DerKodex-Repo-Curator/pursuit-drone/docs/media/arch_01_vision.png

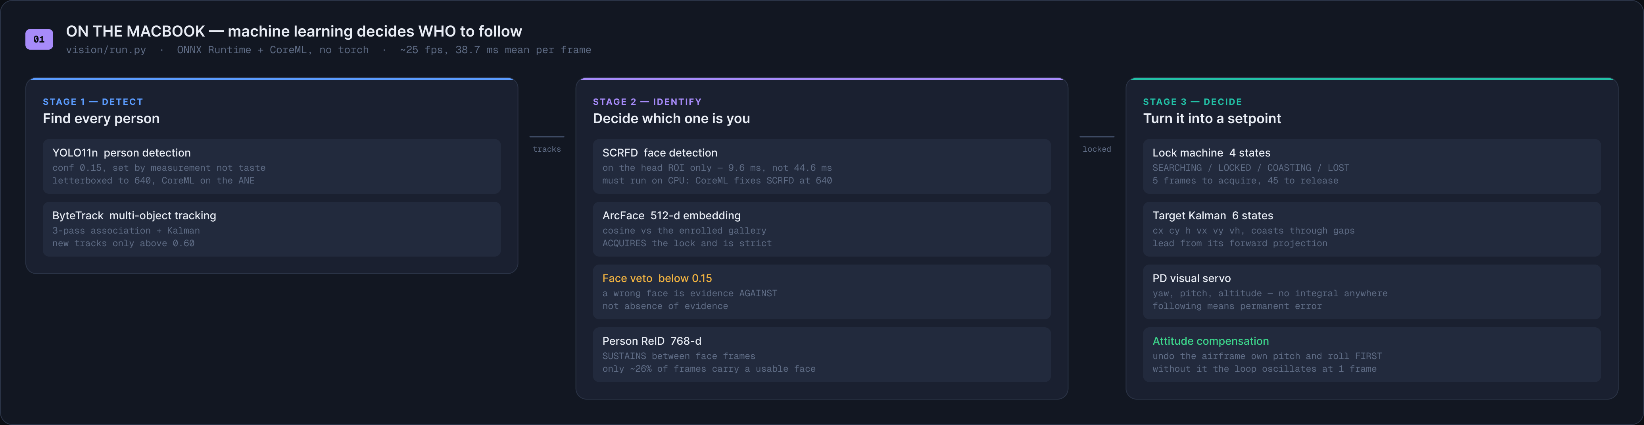
docs/media/arch_01_vision.png
