DerKodex-Repo-Curator/pursuit-drone/docs/media/arch_02_link.png

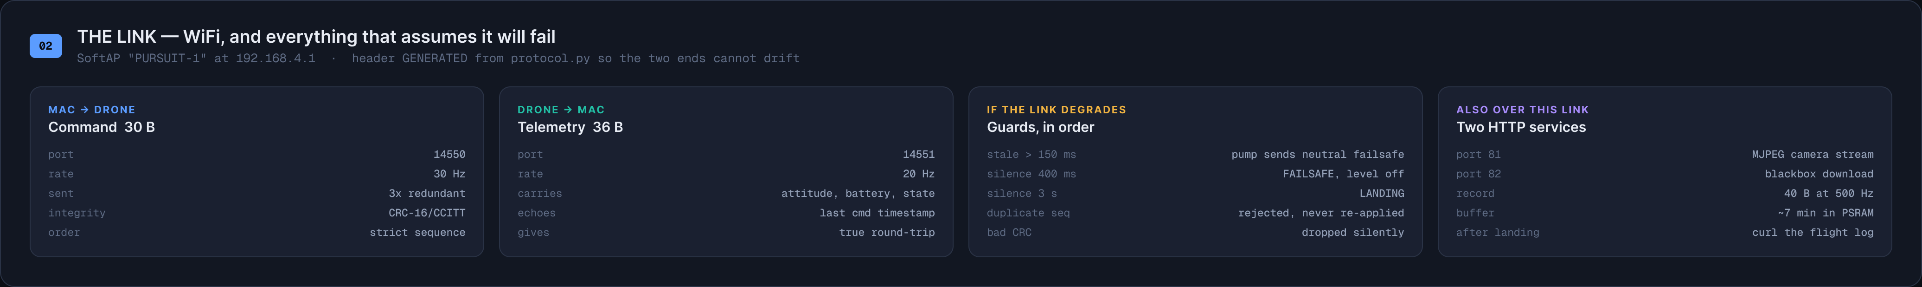
docs/media/arch_02_link.png
