DerKodex-Repo-Curator/pursuit-drone/docs/media/arch_03_firmware.png

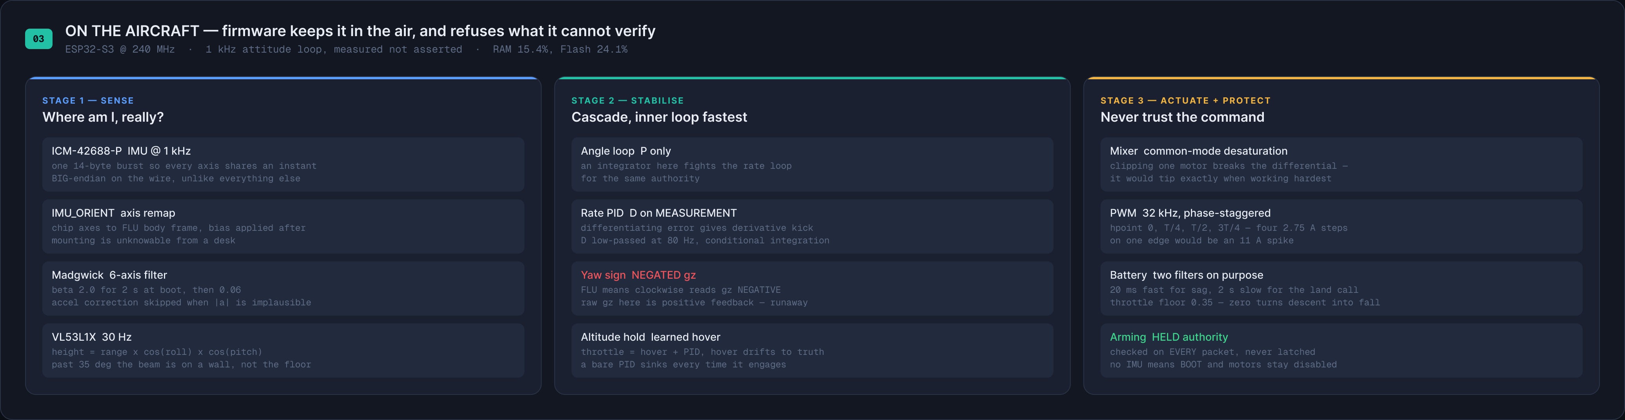
docs/media/arch_03_firmware.png
