DerKodex-Repo-Curator/pursuit-drone/docs/media/figjam_01_vision_pipeline.png

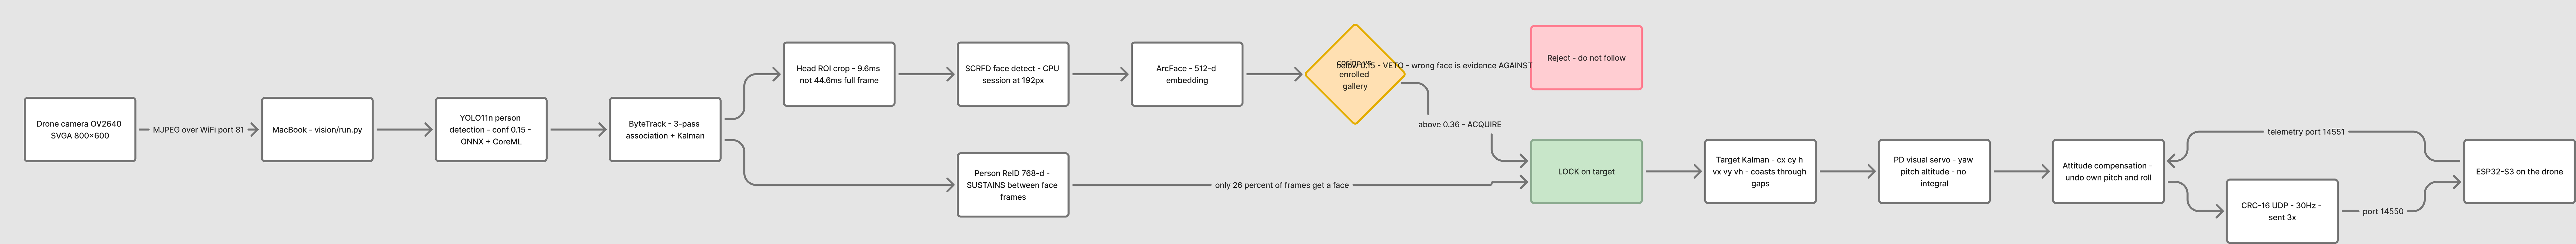
docs/media/figjam_01_vision_pipeline.png
