DerKodex-Repo-Curator/pursuit-drone/docs/media/figjam_02_firmware_loop.png

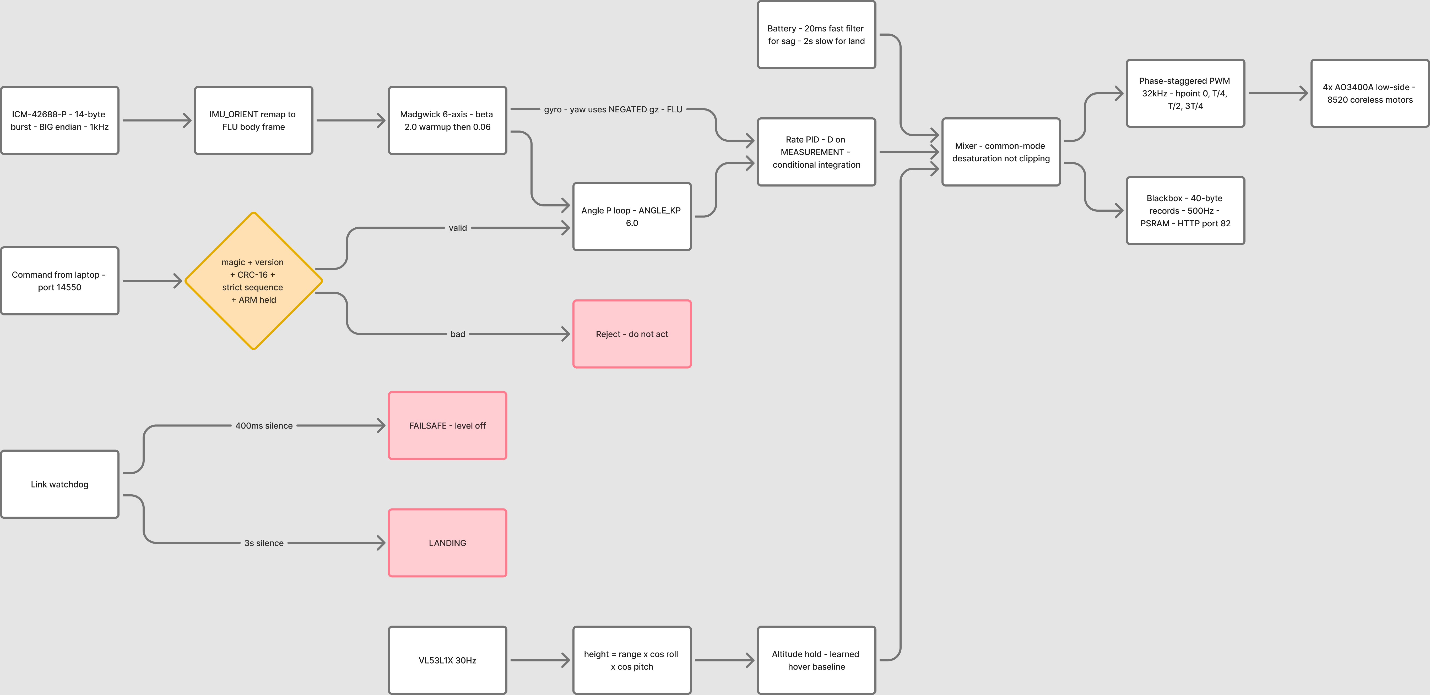
docs/media/figjam_02_firmware_loop.png
