DerKodex-Repo-Curator/pursuit-drone/docs/media/figjam_03_connect.png

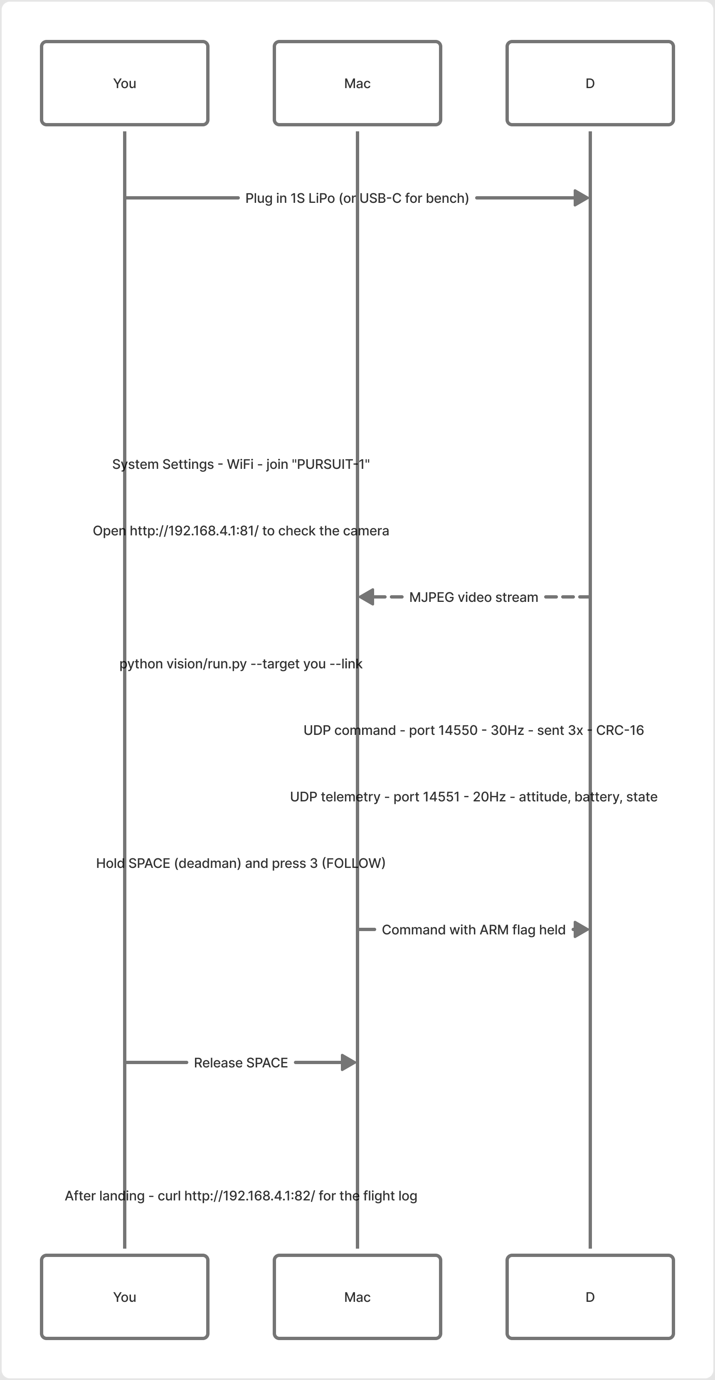
docs/media/figjam_03_connect.png
