DerKodex-Repo-Curator/pursuit-drone/docs/media/figjam_04_control_modes.png

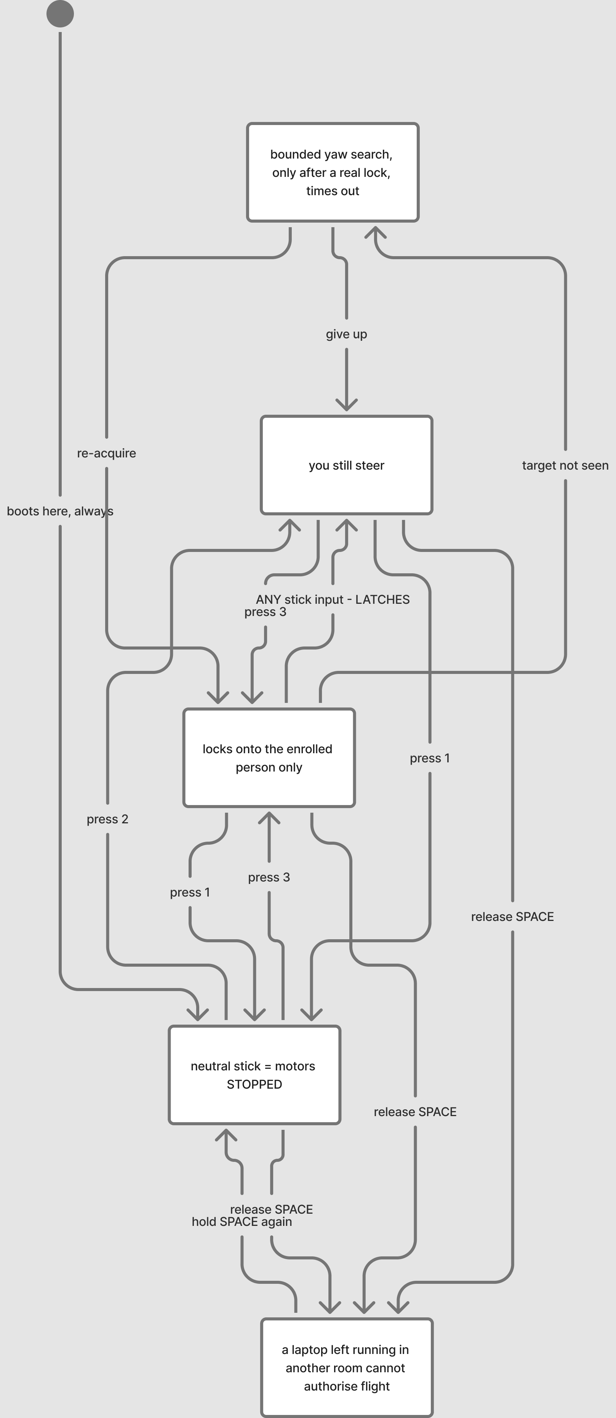
docs/media/figjam_04_control_modes.png
