DerKodex-Repo-Curator/pursuit-drone/docs/media/pursuit_architecture.png

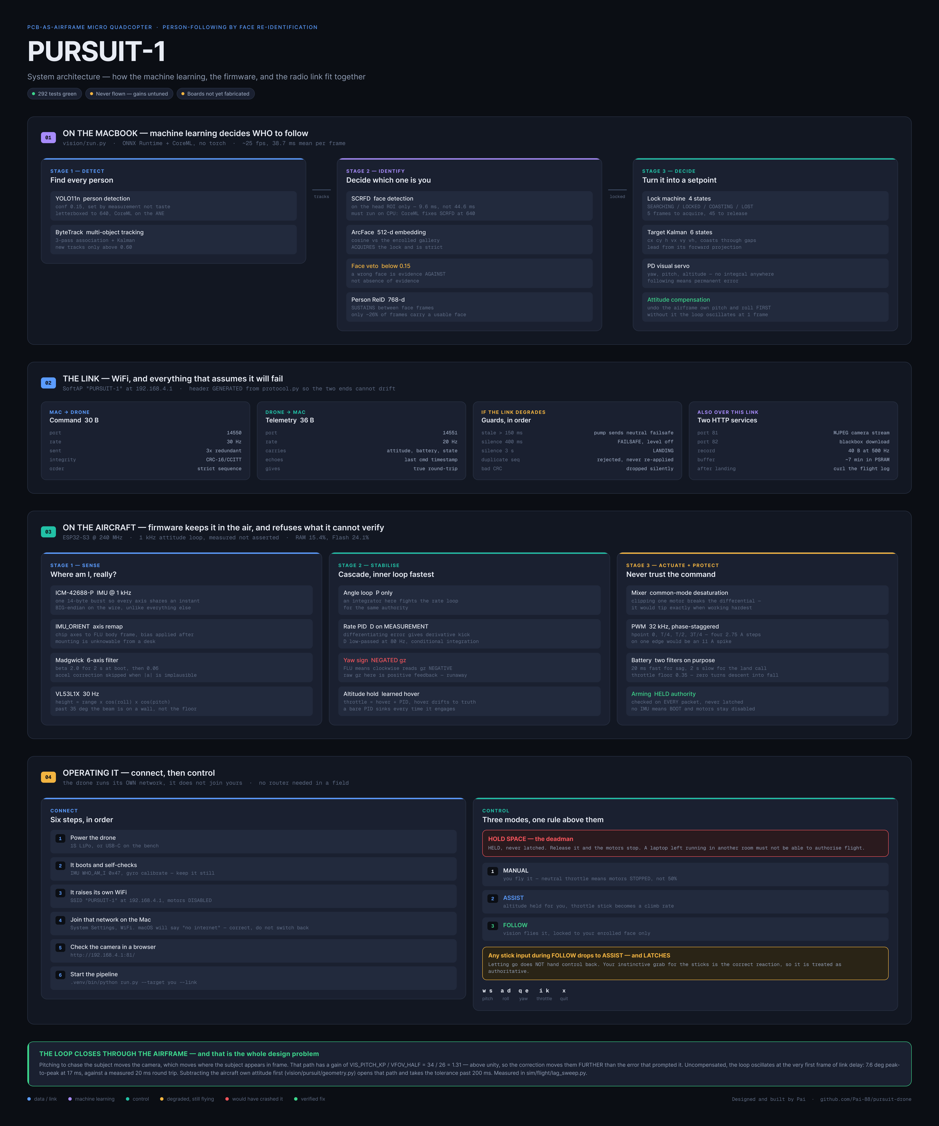
docs/media/pursuit_architecture.png
