DerKodex-Repo-Curator/pursuit-drone/docs/media/pursuit_mindmap.png

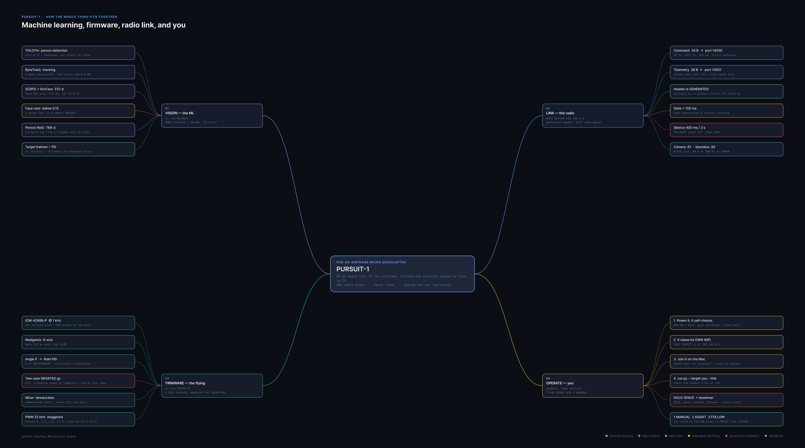
docs/media/pursuit_mindmap.png
