DerKodex-Repo-Curator/pursuit-drone/docs/media/pursuit_process_map.png

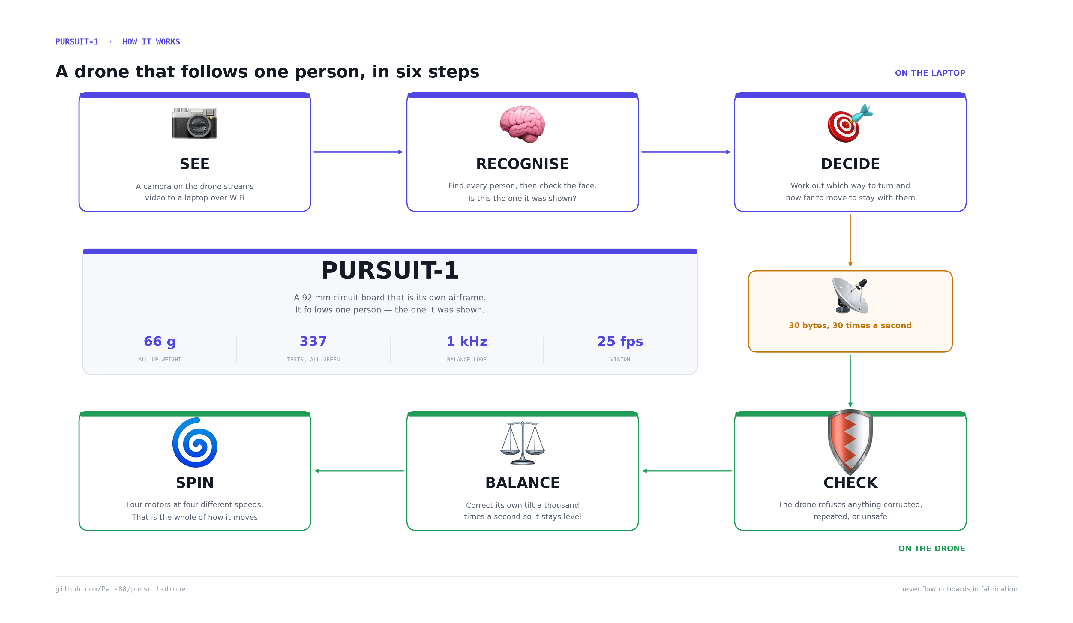
docs/media/pursuit_process_map.png
