DerKodex-Repo-Curator/pursuit-drone/docs/media/training_curves.png

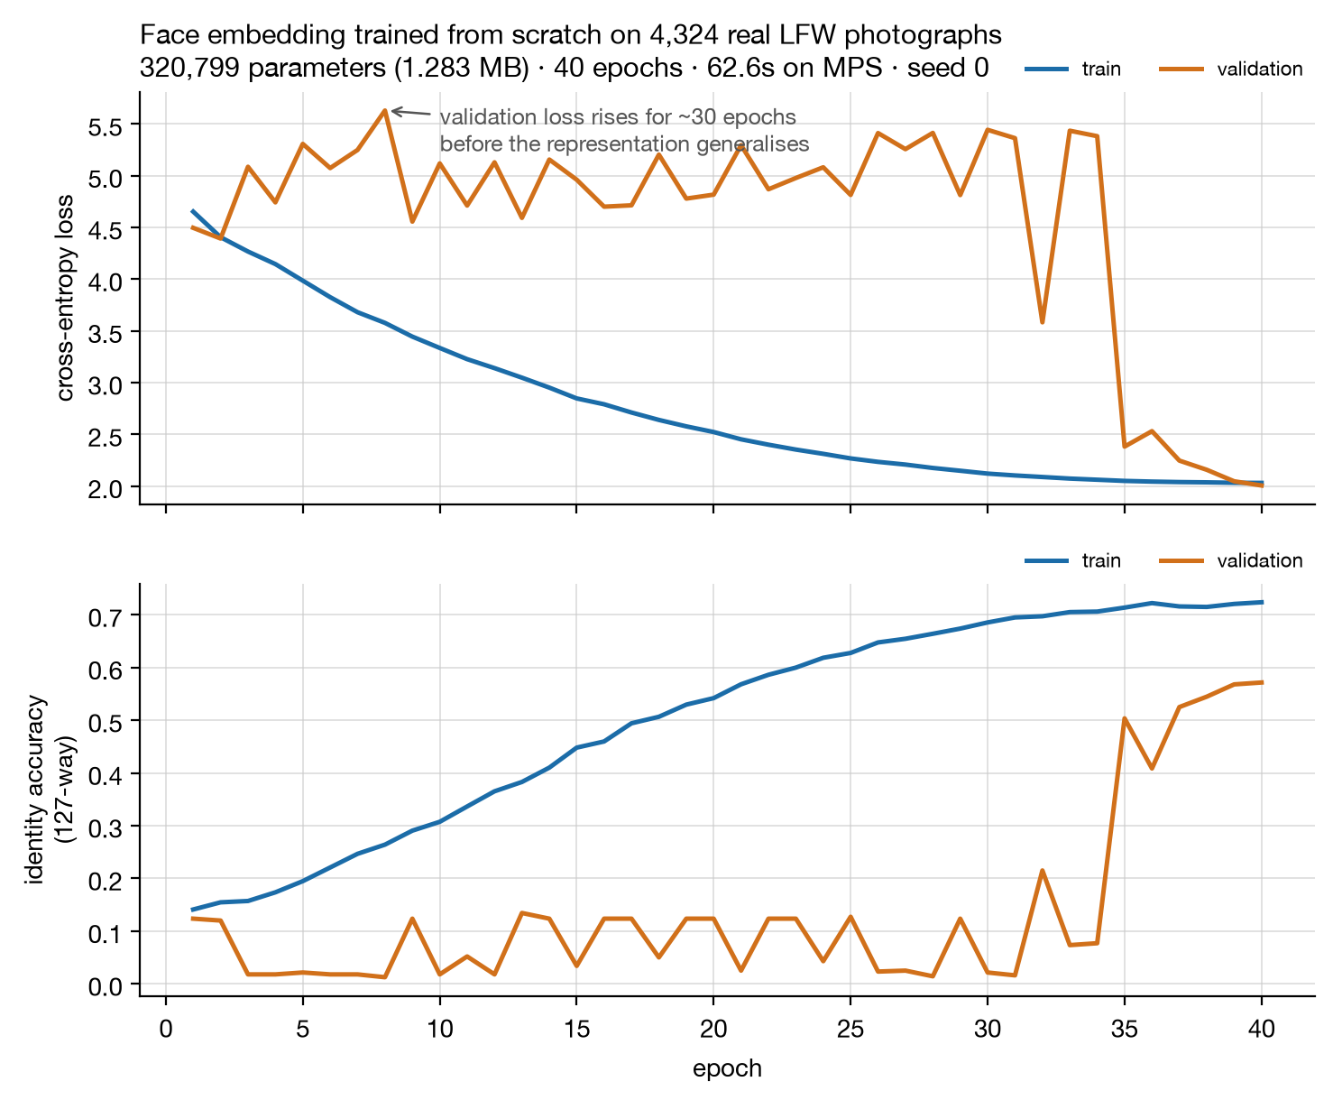
docs/media/training_curves.png
