DerKodex-Repo-Curator/pursuit-drone/gerbers/BOM.csv

Supplied by | Ref | Qty | Value | Package | Part / where to buy | Notes
JLCPCB | U2 | 1 | ICM-42688-P | LGA-14 2.5x3mm | LCSC C1850418 (~USD 17 each; Extended part) | 6-axis IMU. LCSC's own MOQ is 100pcs - do NOT try to buy this yourself at qty 1-2, use JLCPCB's PCBA library (or Mouser 410-ICM-42688-P / Farnell for a single). Forces X-ray inspection. MSL1 - no bake. NEVER ultrasonic-clean.
JLCPCB | Q1-Q4 | 4 | AO3400A | SOT-23 | LCSC C20917 (~GBP 0.05 ea) - marking A09T | 30V 5.7A logic-level NMOS - the standard whoop motor FET
JLCPCB | D1-D4 | 4 | SS34 | SMA/DO-214AC | LCSC C8678 | 3A Schottky flyback. Cathode band faces VBAT (marked on silk)
JLCPCB | R1-R4 | 4 | 100R | 0603 | LCSC C22775 | gate series resistors
JLCPCB | R5-R8 | 4 | 1k | 0603 | LCSC C21190 | gate pulldowns - motors stay off during boot. 1k not 10k: it bounds the gate below the AO3400A threshold even against an unexpected ~45k pull-up on a PWM pin (10k would give 0.60V, within 50mV of the 0.65V minimum), and discharges the gate ~10x faster when the pin goes high-Z.
JLCPCB | R9-R10 | 2 | 4.7k | 0603 | LCSC C23162 | I2C pullups
JLCPCB | R11-R12 | 2 | 10k | 0603 | LCSC C25804 | battery divider (4.2V -> 2.1V ADC). STOCK LIVE-VERIFIED 2026-08-30 (LCSC: 1,136,900 in stock) - the snapshot zero was stale. If the cart ever disagrees, C2906982 (FRC0603F1002TS) is a verified identical-spec drop-in (Extended, +$3 setup). Do NOT use C23192, it is 510k not 10k. REV B: 10k, was 100k (C25803 - one digit apart, check the line you order). A 100k/100k divider presents ~50k to the ESP32-S3 ADC, which needs <10k to charge its sample-and-hold; during bring-up that produced a textbook-looking battery sag under throttle - r2 ~ 1.0 against PWM duty - that was entirely an artefact of the divider. 10k/10k presents 5k and draws 210uA from the pack.
JLCPCB | R13-R14 | 2 | 150R | 0603 | LCSC C22808 | LED series resistors. 150R not 470R - see the LED rows: with a ~2.0V Vf part on a 3.3V GPIO, 150R gives ~7-8mA.
JLCPCB | C2 | 1 | 10nF X7R | 0603 | LCSC C57112 | IMU bypass at the C2 SITE (routes to U2 pin 5 VDDIO). NOTE: the value<->site mapping is set by the routing - fit exactly what this row says, do not go by the old assumption that C2=100nF.
JLCPCB | C3 | 1 | 100nF X7R | 0603 | LCSC C14663 | IMU bypass at the C3 SITE (routes to U2 pin 8 VDD, 3.9mm away). This is the datasheet-mandated 100nF on VDD.
JLCPCB | C4 | 1 | 2.2uF X5R 16V | 0603 | LCSC C23630 (Extended) | IMU bulk on the VDDIO side (TDK BOM)
DO NOT FIT | C6 | 0 | 22uF X5R 25V | 0805 | LCSC C45783 (pads only) | PADS ONLY - deliberately excluded from the JLCPCB BOM/CPL. The XIAO 3V3 rail is an SGM6029C buck whose datasheet recommends 5-10uF EFFECTIVE output capacitance; the module already carries 9.4uF nominal. Fitting C6+C7 put ~50-64uF effective on that node. Only fit if bring-up shows the 3V3 rail actually sagging.
DO NOT FIT | C7 | 0 | 100uF X5R 6.3V | 1206 | LCSC C15008 (pads only) | PADS ONLY - see C6. Adding capacitance to a bare pad takes five minutes; removing a reflowed 1206 sitting 7.3mm from a 0.5mm-pitch LGA does not.
JLCPCB | C8 | 1 | 100nF | 0603 | LCSC C14663 | ADC sense filter
JLCPCB | LED1 | 1 | yellow LED 0805 | 0805 | LCSC C84261 (NationStar NCD0805Y1) | FRONT orientation LED. Vf 1.6-2.6V. NOT white or blue: every white/blue 0805 is InGaN with Vf specified as a 2.6-3.6V BIN RANGE, and the upper bins simply never conduct from a 3.3V GPIO. No resistor value fixes that.
JLCPCB | LED2 | 1 | red LED 0805 | 0805 | LCSC C84256 (NationStar NCD0805R1) | REAR orientation LED. Vf 1.6-2.6V. Both LEDs share one GPIO (LED_CTRL) so they are always on together - colour, not blink pattern, is what tells you nose from tail.
YOU | C1 | 1 | 220-470uF 6.3V POLYMER ESR<=30mOhm ripple>=2A | 7343/D case (2917) | Panasonic 6TPE220MI / 6TPE330MI or Kemet polymer equivalent | BELLY. MUST be polymer/tantalum. POLARITY: the belly silk marks '+ C1' beside pad 1. Reversed across an unfused LiPo this vents.
JLCPCB | C10-C13 | 4 | 100nF 16V X7R | 0603 | LCSC C14663 | VBAT ceramic bypass, one at each flyback. REV C: moved from the BELLY to the TOP face, so JLCPCB places them now - four fewer hand joints, and it keeps the assembly run single-sided. Do not omit: without these nothing on the board handles the MHz content of the switching edges.
YOU | U1 | 1 | Seeed XIAO ESP32S3 Sense **PRE-SOLDERED** | module on 2x 1x7 FEMALE sockets | Seeed 102010635 "XIAO ESP32S3 Sense (Pre-Soldered)" ~USD 14.90 - NOT the bare one | BUY THE PRE-SOLDERED VERSION and fit FEMALE 2.54mm SOCKET strips to the board, not male pins. Seeed have already soldered the module side, so 14 of the board's 58 hand joints simply do not exist - for about GBP 2. Same THT footprint, so no board change. Two further wins: the module becomes REMOVABLE (a dead XIAO stops meaning a dead board, which has already happened once), and it sits ~8.5mm up instead of ~2.5mm. USB edge faces the board front - marked on silk three ways. Comes with camera + U.FL antenna. NOTE: the Sense expansion board's three 4.7k SD pull-ups (behind solder pad J3) land on D9/MISO, D10/MOSI and SD_CS - i.e. on IMU_INT and LED_CTRL here, both harmless. Cutting J3 is optional and costs the microSD slot, which this build does not use.
YOU | J1 | 1 | JST S2B-PH-K-S | right-angle THT | LCSC C173752 / any | battery connector. CHECK PACK POLARITY WITH A METER FIRST - JST-PH is not standardized! The top silk marks '+' beside pad 1.
YOU | J2 | 1 | Pololu VL53L1X carrier #3415 | 7-pin breakout | Pololu 3415 (~GBP 12) via Pimoroni/Mouser | ToF altitude sensor. Mount belly-down on a RIGHT-ANGLE 1x7 header so it lies flat
YOU | J4/J5 | - | wire pads | - | - | J4: two short 24AWG wires to the XIAO underside BAT pads. J5: MANDATORY 20AWG battery pigtail — the JST-PH at J1 is rated 2A/contact and SPICE shows 9.82A at full throttle; J1 alone is bench-throttle only | NEVER flight. Preheat the pad (inner VBAT plane heatsinks it) | 60W+ iron | tug-test
YOU | MT1-MT4 motors | 4 | 8520 coreless 8.5x20mm | - | AliExpress/Amazon '8520 motor CW CCW pair' (~GBP 10/4pcs) | Buy 2x CW + 2x CCW. 1.0mm shaft. Verify polarity: red/blue = CW; white/black = CCW (varies by seller!)
YOU | Props | 4+spares | 65mm 2-blade 1.0mm bore | - | '65mm prop 8520/720' combo sets, or Hubsan X4 55mm as fallback | MUST be 1.0mm bore - most modern '65mm whoop' props are 1.5mm bore and will NOT fit
YOU | Battery | 2+ | 1S 650mAh HV LiPo whoop stick (PH2.0) | ~65x19x8mm ~18g | GNB/Gaoneng or BetaFPV 650mAh 1S HV | 650mAh not 450mAh: +5g buys +44% energy, so ~7.2 min hover instead of ~5.4. Same connector, no board change. Also buy a 1S USB charger - the XIAO's ~100mA onboard charge works but is slow.
YOU | Sockets | - | 2.54mm FEMALE socket strips | THT | any | 2x 1x7 FEMALE (for the pre-soldered XIAO - see U1) + 1x7 right-angle MALE for the ToF breakout. Female sockets are the whole point: the module plugs in instead of being soldered down."
YOU | Camera mount | 1 | foam wedge or printed edge clip | - | - | No screw holes: every bracket position sat on a drive stage, and metal M2 hardware there would bridge VBAT (head) to GND (nut) through the board. Clip/tape the camera to the front edge.
YOU | Zip ties | 8+ | 2.5mm mini cable ties | - | any | motor retention through the ring holes + battery strap
YOU | Pigtail-J5 | 1 | 20AWG silicone, 60mm, red/black heat-shrink, JST-PH2.0 pack end | - | any | BUILD AND METER THIS BEFORE ANY PACK IS ON THE BENCH. The only lead that ever plugs into J1. Reversal defence is polarity discipline, not a fuse: a reversed pack drives ~20A through Q1-Q4 body diodes and kills the XIAO in ms, long before any fuse opens. Optional fuse must be <=10mOhm measured (sag margin is 0.11V) and worst_case.cir re-run with it.
