DerKodex-Repo-Curator/pursuit-drone/docs/media/arch_04_operate.png

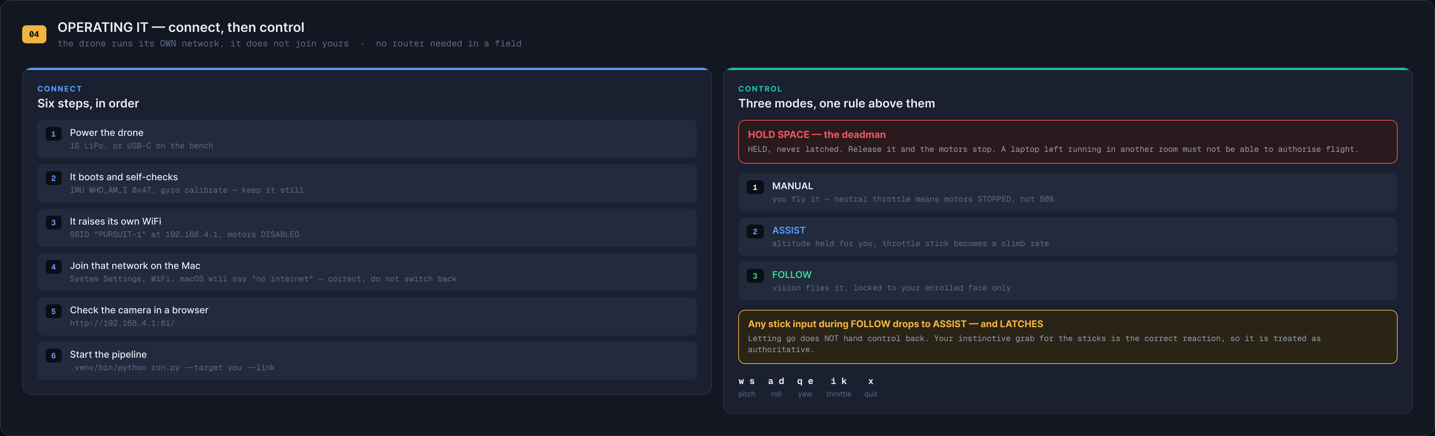
docs/media/arch_04_operate.png
