DerKodex-Repo-Curator/pursuit-drone/docs/media/verification_bench.png

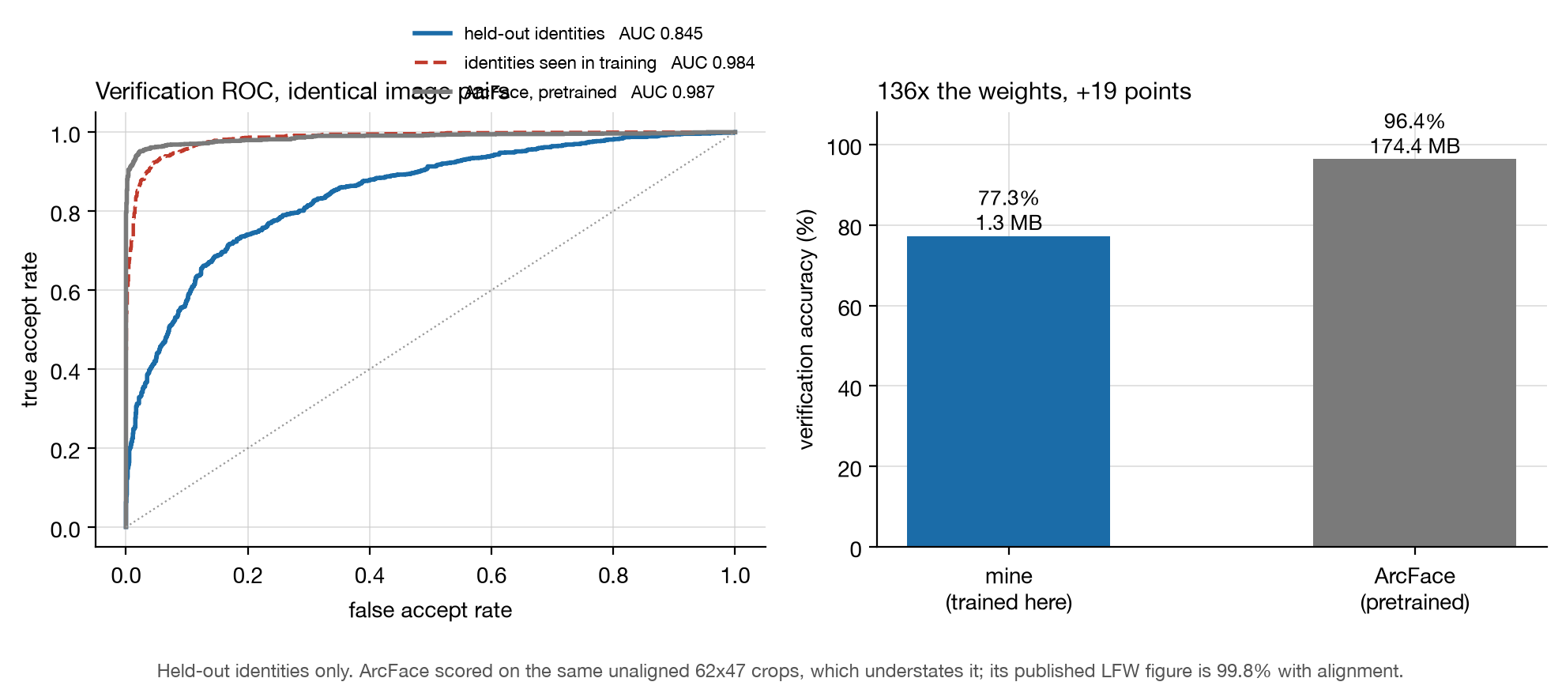
docs/media/verification_bench.png
