DerKodex-Repo-Curator/pursuit-drone/docs/media/verification_roc.png

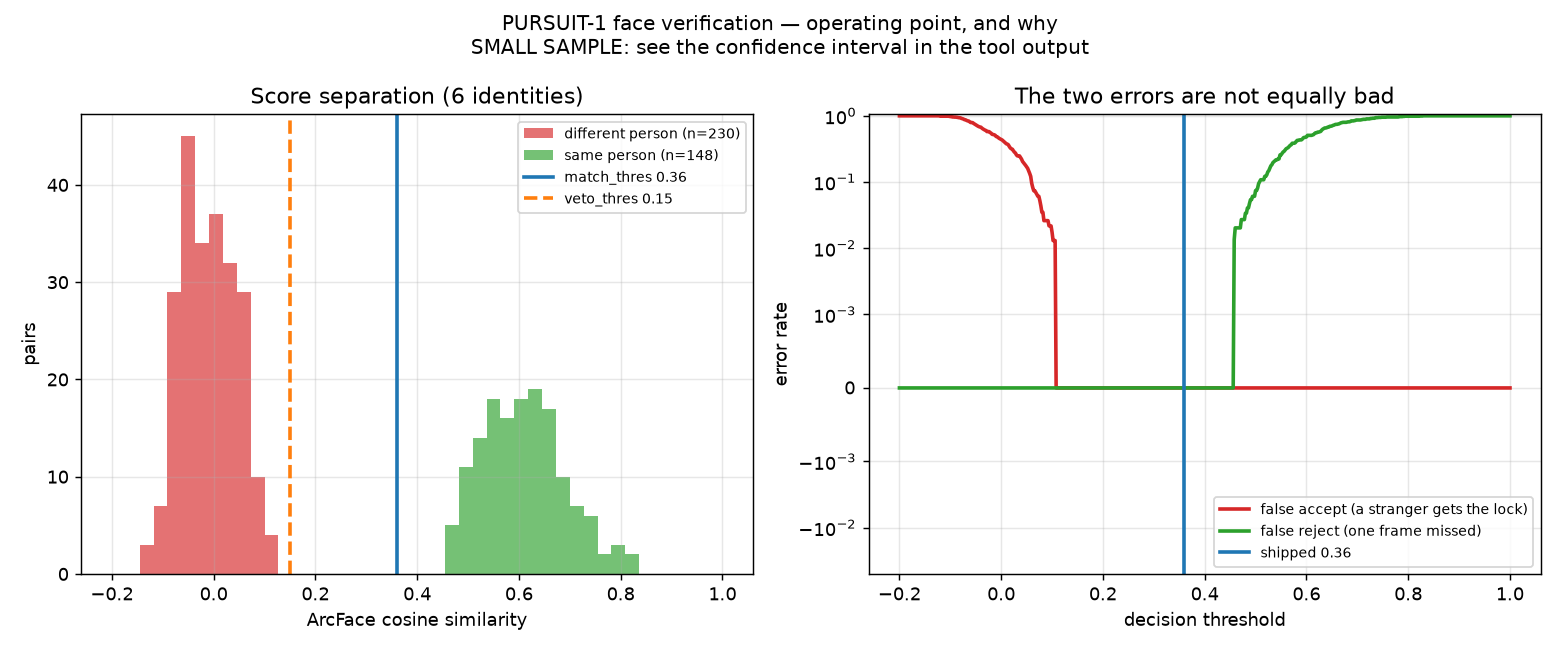
docs/media/verification_roc.png
