DerKodex-Repo-Curator/pursuit-drone/gerbers/PURSUIT-1_schematic.pdf

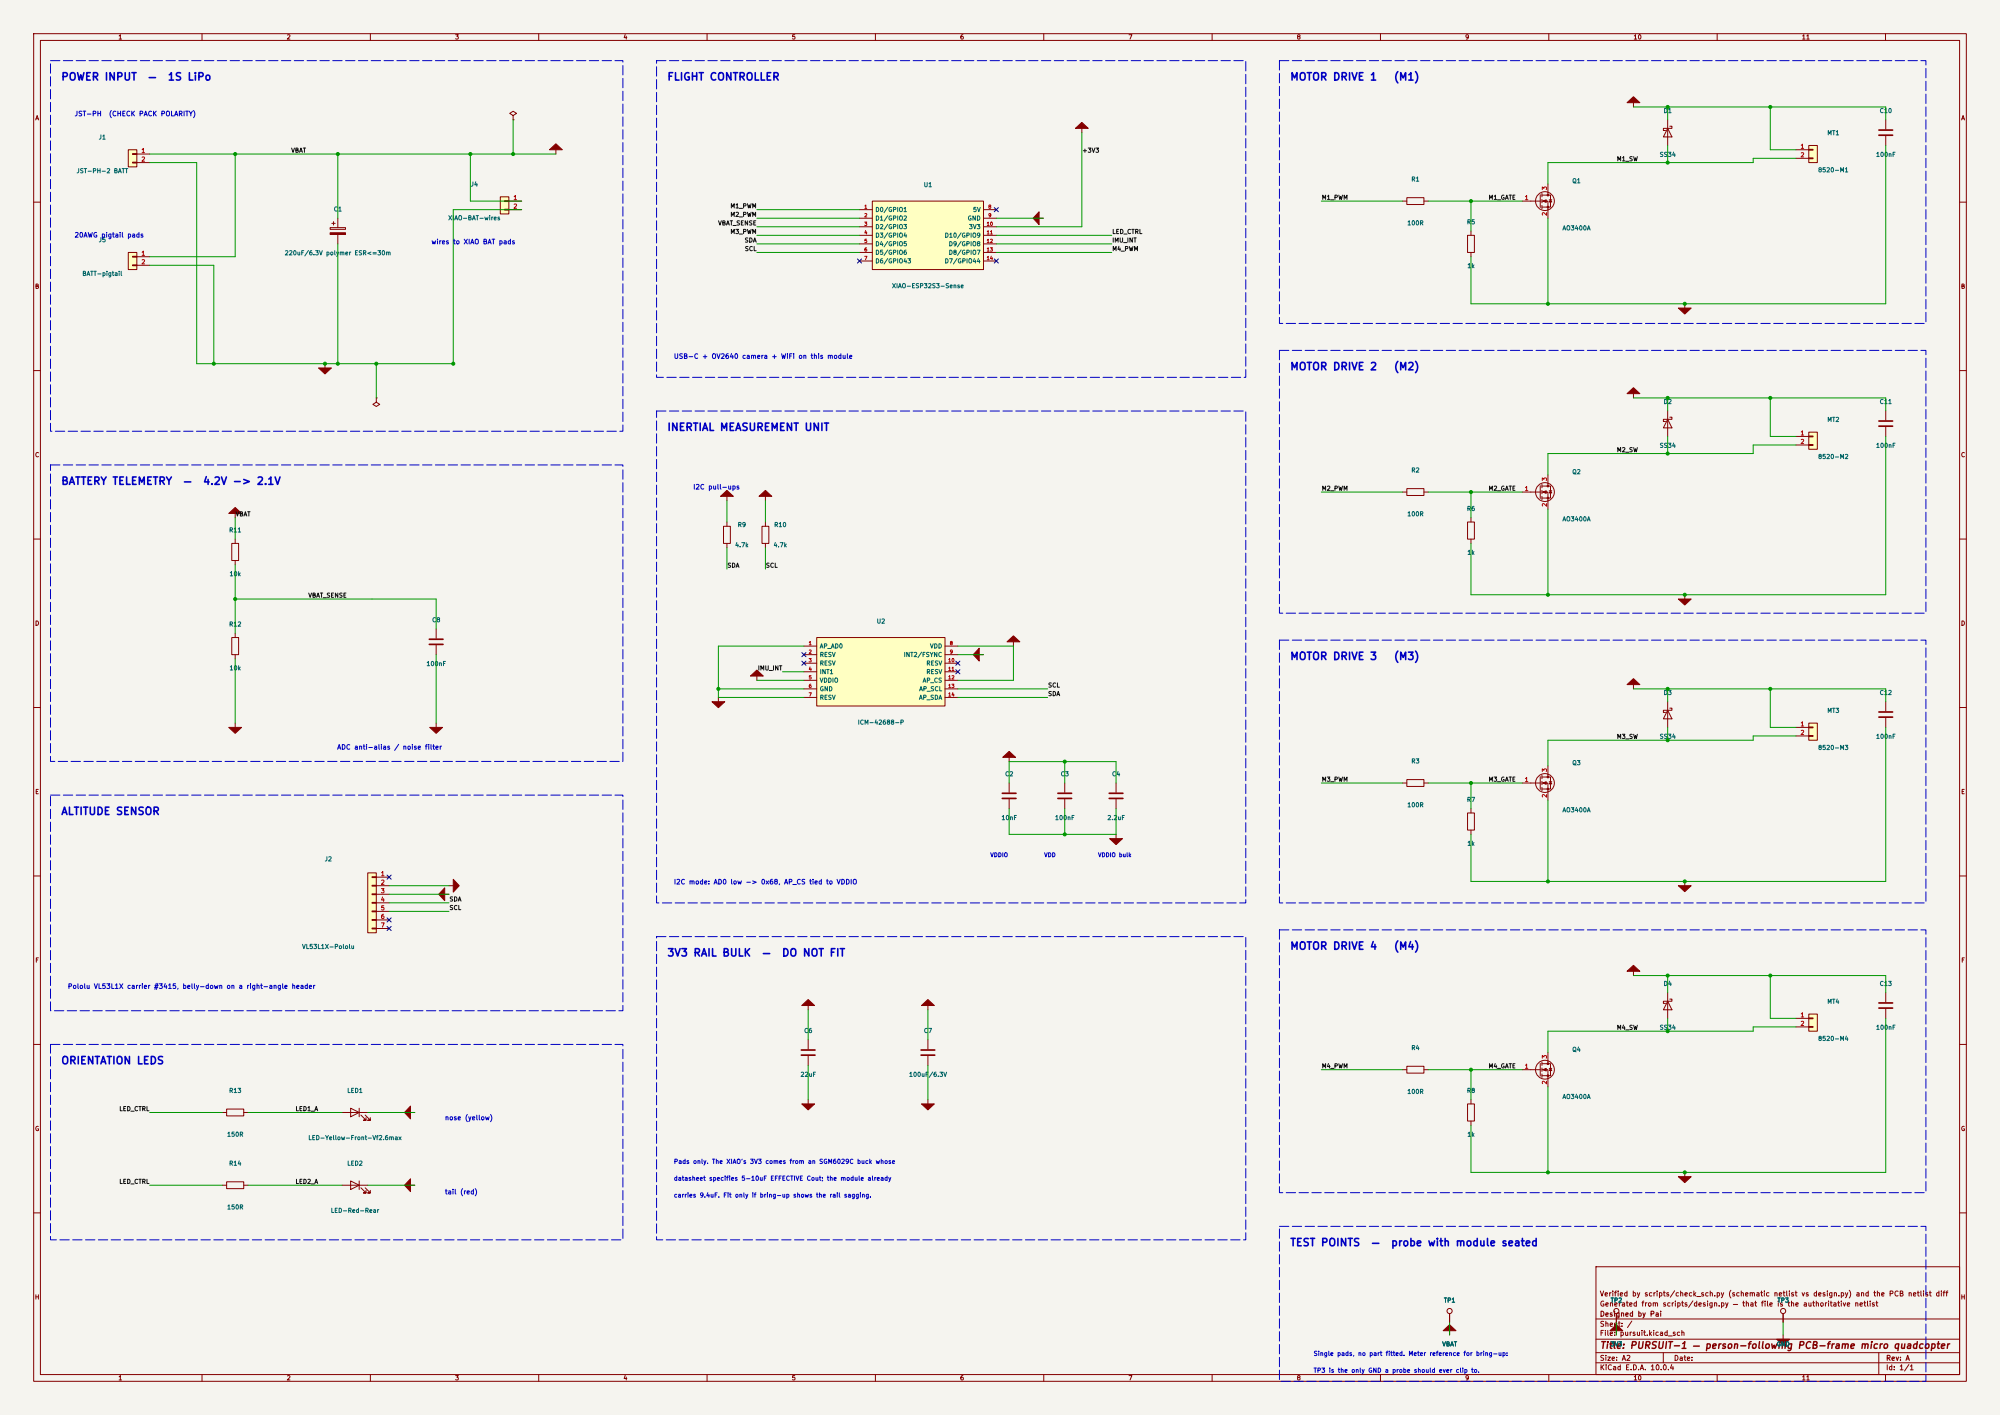
[picture p21: page 1]

JST-PH (CHECK PACK POLARITY)

wires to XIAO BAT pads

USB-C + OV2640 camera + WiFi on this module

VDDIO bulk BATTERY TELEMETRY — 4.2V -> 2.1V

ADC anti-alias / noise filter

I2C mode: AD0 low -> 0x68, AP_CS tied to VDDIO

3V3 RAIL BULK — DO NOT FIT

Pololu VL53L1X carrier #3415, belly-down on a right-angle header

Pads only. The XIAO's 3V3 comes from an SGM6029C buck whose

datasheet specifies 5-10uF EFFECTIVE Cout; the module already

carries 9.4uF. Fit only if bring-up shows the rail sagging.

TEST POINTS — probe with module seated

Verified by scripts/check_sch.py (schematic netlist vs design.py) and the PCB netlist diff
Generated from scripts/design.py — that file is the authoritative netlist
Designed by Pai
Sheet: /

Title: PURSUIT-1 — person-following PCB-frame micro quadcopter 3V3 3V3
Size: A2 | Rev: A
KiCad E.D.A. 10.0.4 | Id: 1/1

Single pads, no part fitted. Meter reference for bring-up:

TP3 is the only GND a probe should ever clip to.
