DerKodex-Repo-Curator/pursuit-drone/hardware/pursuit.kicad_pcb

## KiCad design hardware/pursuit.kicad_pcb (2026-09-28)

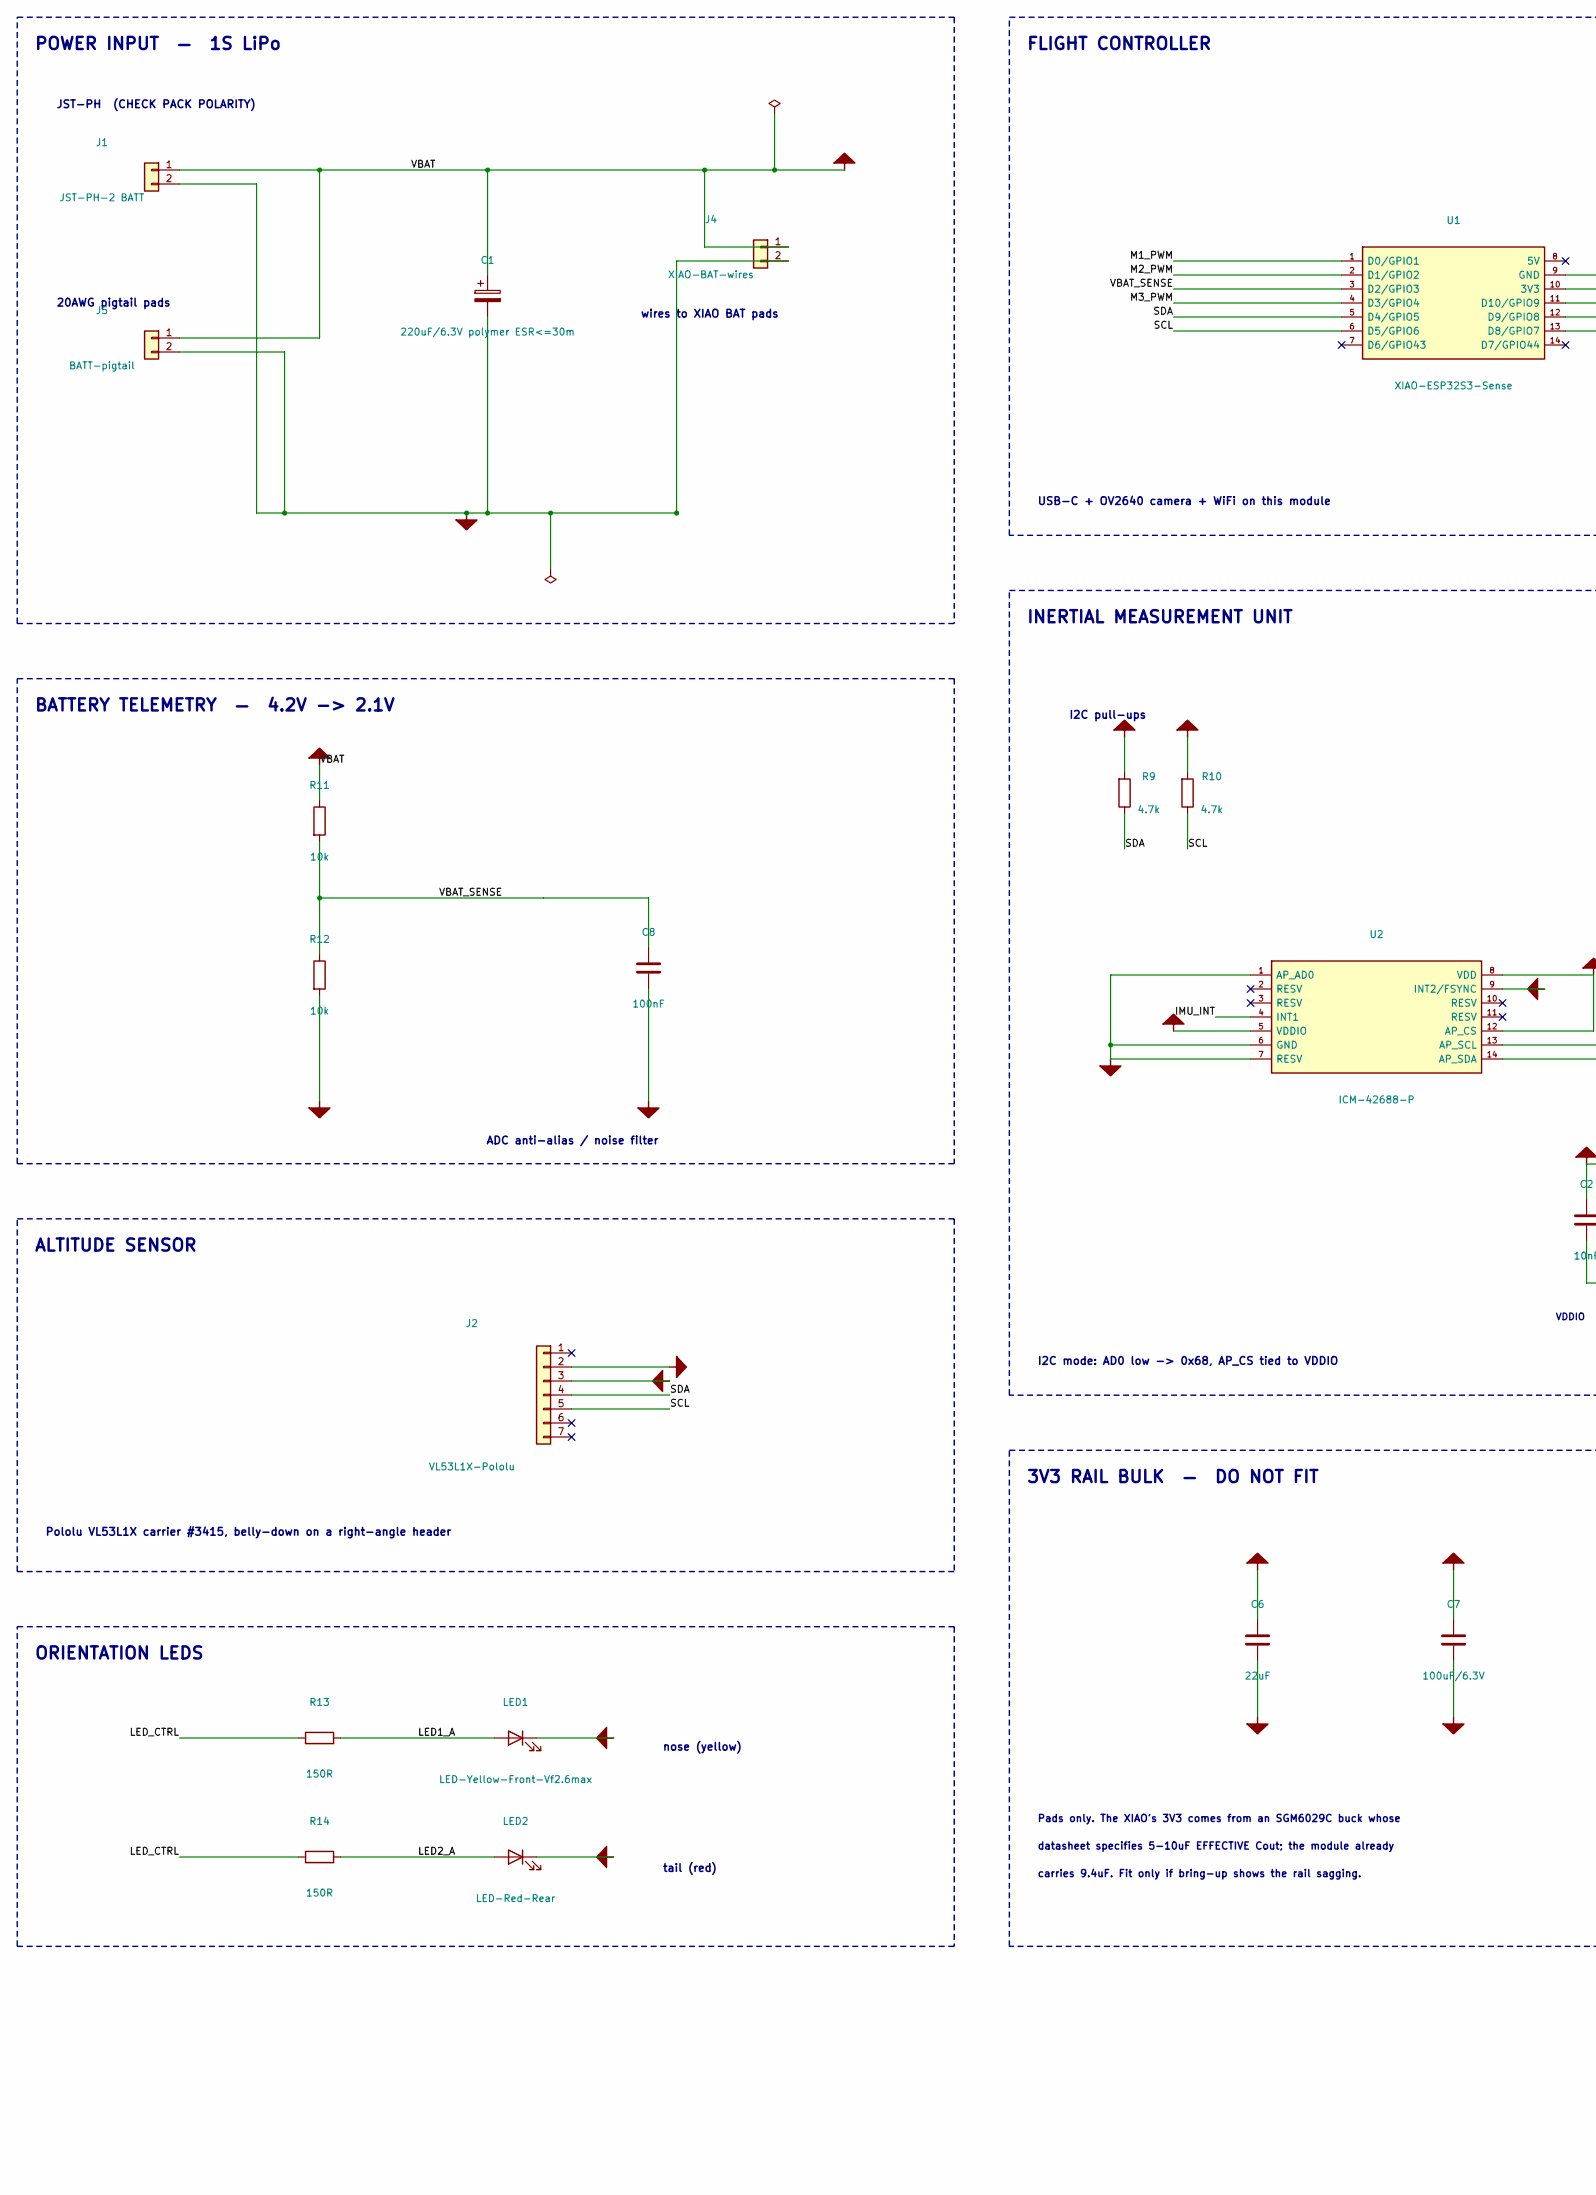
[picture p22: schematic pursuit.kicad_sch, PURSUIT-1 — person-following PCB-frame micro quadcopter, part in row 1, column 1]

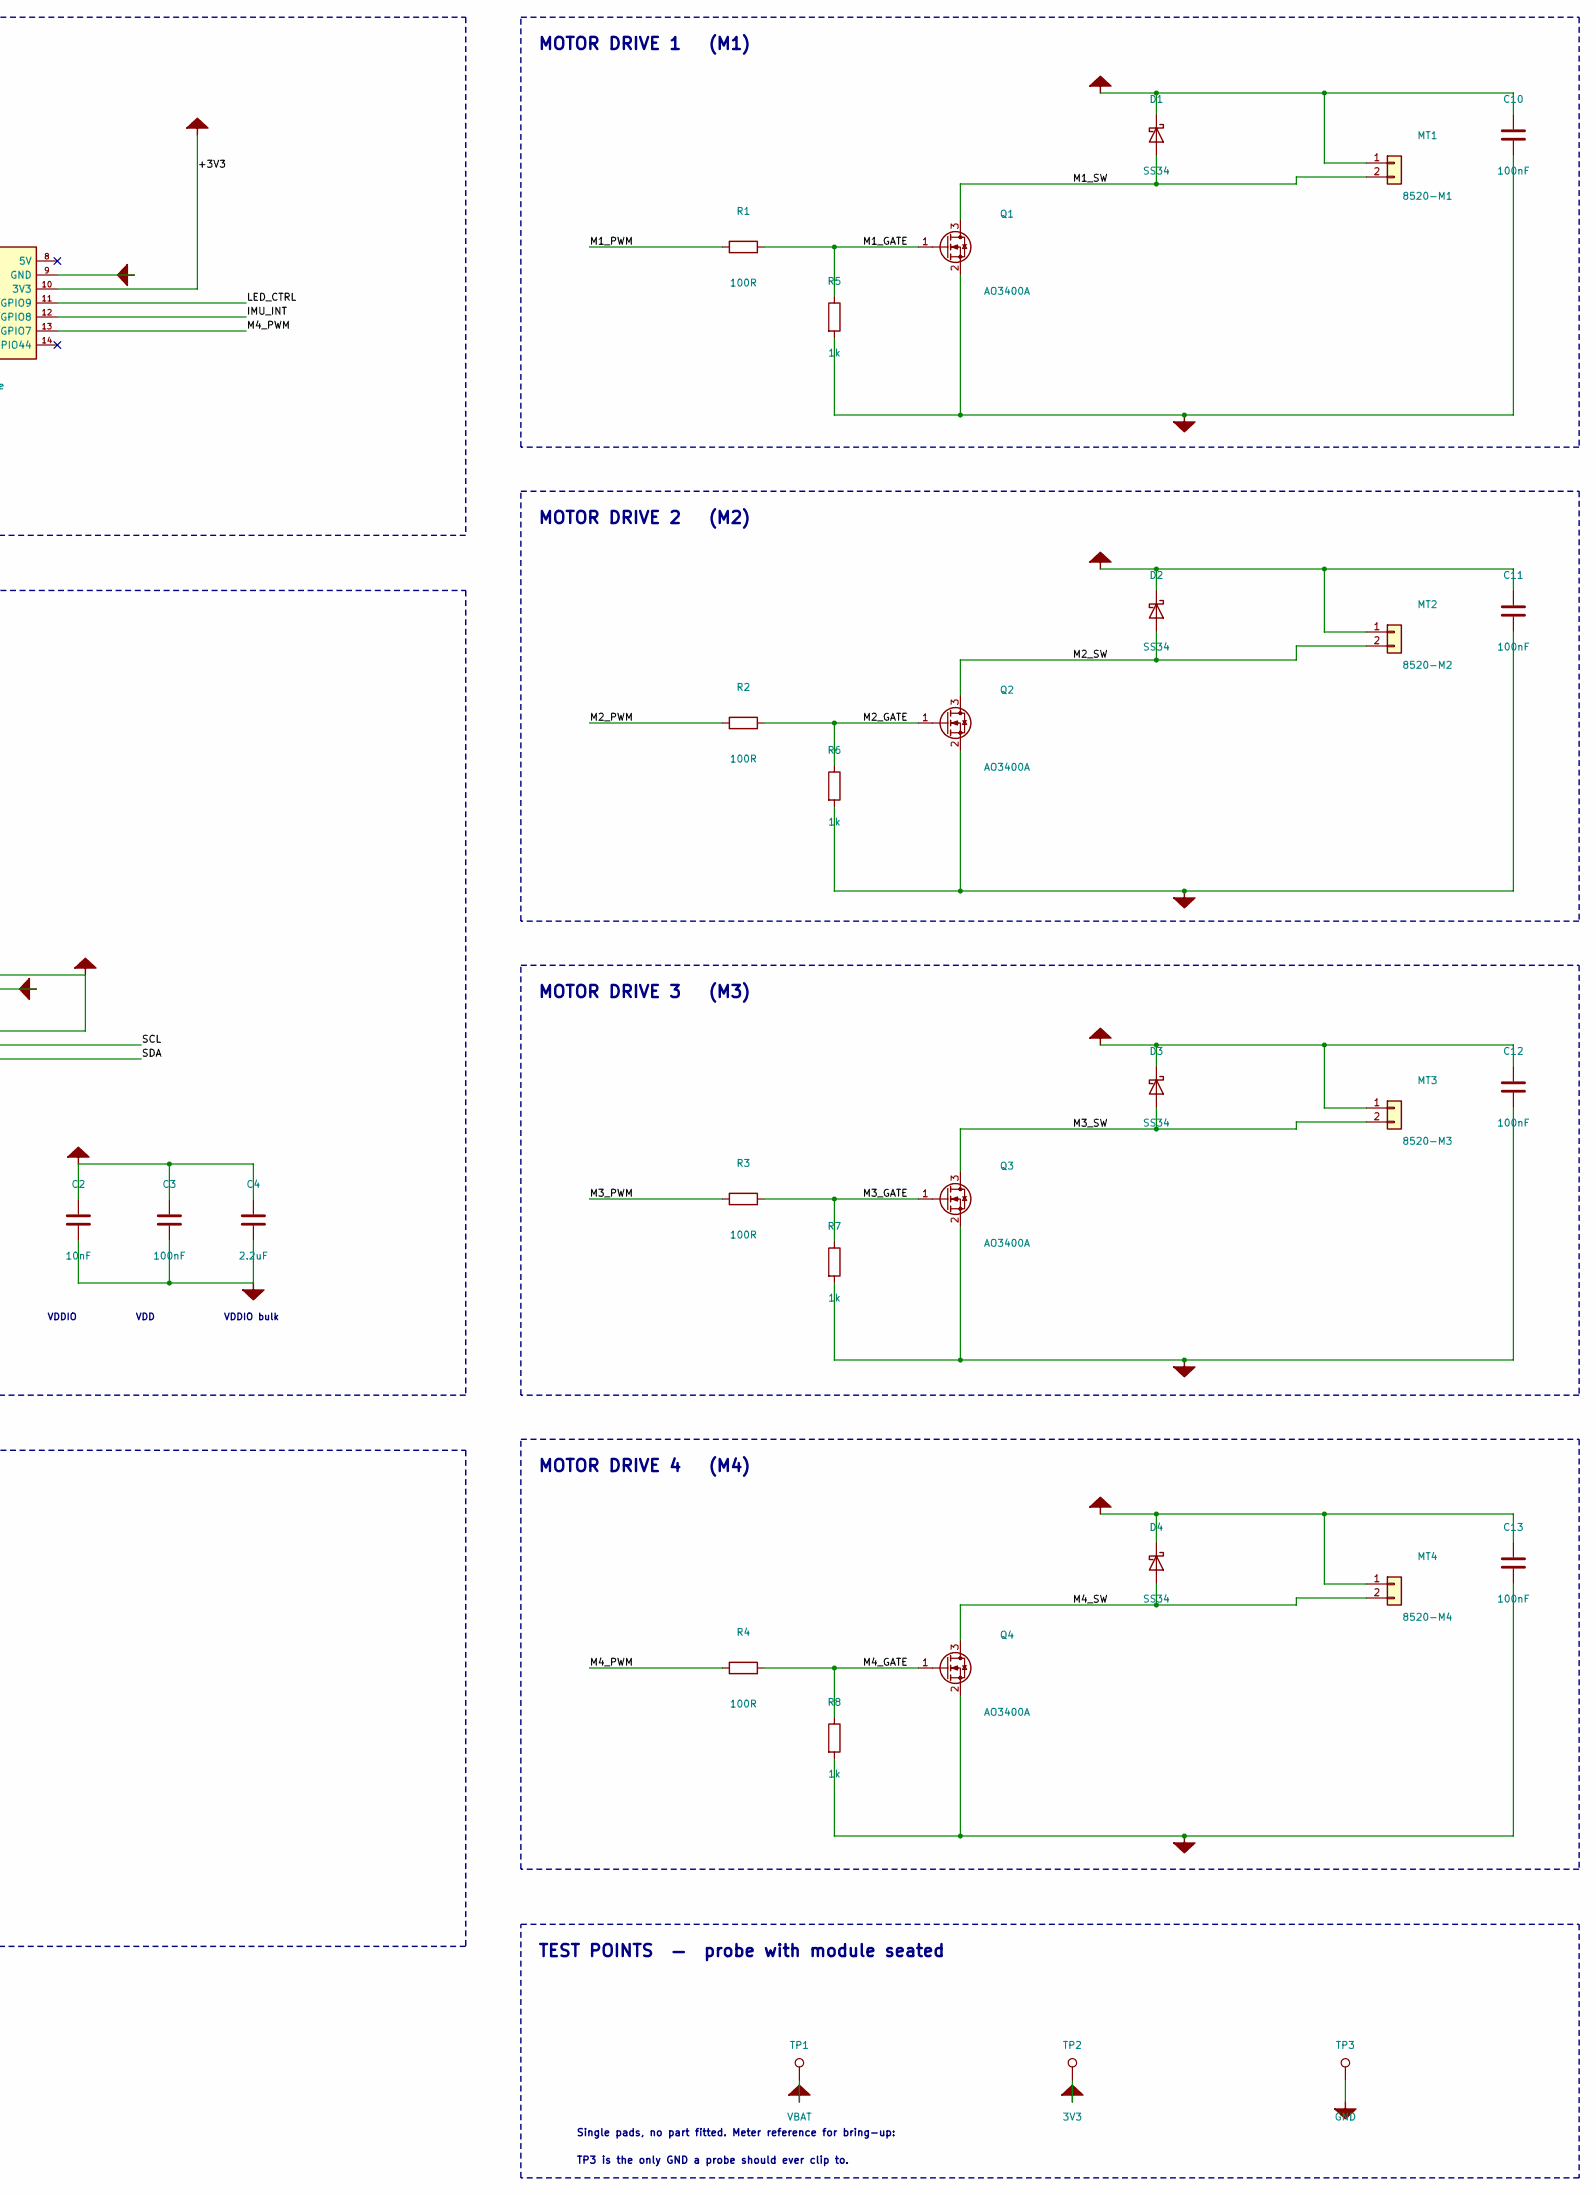
[picture p23: schematic pursuit.kicad_sch, PURSUIT-1 — person-following PCB-frame micro quadcopter, part in row 1, column 2]

Parts:
C1: 220uF/6.3V polymer ESR<=30m; CP_EIA-7343-31_Kemet-D
C2: 10nF; C_0603_1608Metric
C3, C8, C10, C11, C12, C13: 100nF; C_0603_1608Metric
C4: 2.2uF; C_0603_1608Metric
C6: 22uF; C_0805_2012Metric
C7: 100uF/6.3V; C_1206_3216Metric
D1, D2, D3, D4: SS34; D_SMA
J1: JST-PH-2 BATT; JST_PH_S2B-PH-K_1x02_P2.00mm_Horizontal
J2: VL53L1X-Pololu; PinHeader_1x07_P2.54mm_Vertical
J4: XIAO-BAT-wires; Wire_Pads_2x
J5: BATT-pigtail; Wire_Pads_2x_HD
LED1: LED-Yellow-Front-Vf2.6max; LED_0805_2012Metric
LED2: LED-Red-Rear; LED_0805_2012Metric
MT1: 8520-M1; Motor_Pads_2x
MT2: 8520-M2; Motor_Pads_2x
MT3: 8520-M3; Motor_Pads_2x
MT4: 8520-M4; Motor_Pads_2x
Q1, Q2, Q3, Q4: AO3400A; SOT-23
R1, R2, R3, R4: 100R; R_0603_1608Metric
R5, R6, R7, R8: 1k; R_0603_1608Metric
R9, R10: 4.7k; R_0603_1608Metric
R11, R12: 10k; R_0603_1608Metric
R13, R14: 150R; R_0603_1608Metric
TP1: VBAT; TestPoint_1mm
TP2: 3V3; TestPoint_1mm
TP3: GND; TestPoint_1mm
U1: XIAO-ESP32S3-Sense; XIAO_ESP32S3_Carrier
U2: ICM-42688-P; ICM42688P_LGA14

Connections:
+3V3: C2.1, C3.1, C4.1, C6.1, C7.1, J2.2, R9.2, R10.2, TP2.1, U1.10 (3V3), U2.5 (VDDIO), U2.8 (VDD), U2.12 (AP_CS)
IMU_INT: U1.12 (D9/GPIO8), U2.4 (INT1)
LED1_A: LED1.2 (A), R13.2
LED2_A: LED2.2 (A), R14.2
LED_CTRL: R13.1, R14.1, U1.11 (D10/GPIO9)
M1_GATE: Q1.1 (G), R1.2, R5.1
M1_PWM: R1.1, U1.1 (D0/GPIO1)
M1_SW: D1.2 (A), MT1.2, Q1.3 (D)
M2_GATE: Q2.1 (G), R2.2, R6.1
M2_PWM: R2.1, U1.2 (D1/GPIO2)
M2_SW: D2.2 (A), MT2.2, Q2.3 (D)
M3_GATE: Q3.1 (G), R3.2, R7.1
M3_PWM: R3.1, U1.4 (D3/GPIO4)
M3_SW: D3.2 (A), MT3.2, Q3.3 (D)
M4_GATE: Q4.1 (G), R4.2, R8.1
M4_PWM: R4.1, U1.13 (D8/GPIO7)
M4_SW: D4.2 (A), MT4.2, Q4.3 (D)
SCL: J2.5, R10.1, U1.6 (D5/GPIO6), U2.13 (AP_SCL)
SDA: J2.4, R9.1, U1.5 (D4/GPIO5), U2.14 (AP_SDA)
VBAT_SENSE: C8.1, R11.2, R12.1, U1.3 (D2/GPIO3)

Notes on the sheet:
MOTOR DRIVE 1 (M1)
MOTOR DRIVE 2 (M2)
MOTOR DRIVE 3 (M3)
MOTOR DRIVE 4 (M4)
POWER INPUT — 1S LiPo
JST-PH (CHECK PACK POLARITY)
20AWG pigtail pads
wires to XIAO BAT pads
FLIGHT CONTROLLER
USB-C + OV2640 camera + WiFi on this module
INERTIAL MEASUREMENT UNIT
I2C mode: AD0 low -> 0x68, AP_CS tied to VDDIO
I2C pull-ups
VDDIO
VDD
VDDIO bulk
TEST POINTS — probe with module seated
Single pads, no part fitted. Meter reference for bring-up:
TP3 is the only GND a probe should ever clip to.
BATTERY TELEMETRY — 4.2V -> 2.1V
ADC anti-alias / noise filter
ALTITUDE SENSOR
Pololu VL53L1X carrier #3415, belly-down on a right-angle header
ORIENTATION LEDS
nose (yellow)
tail (red)
3V3 RAIL BULK — DO NOT FIT
Pads only. The XIAO's 3V3 comes from an SGM6029C buck whose
datasheet specifies 5-10uF EFFECTIVE Cout; the module already
carries 9.4uF. Fit only if bring-up shows the rail sagging.

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
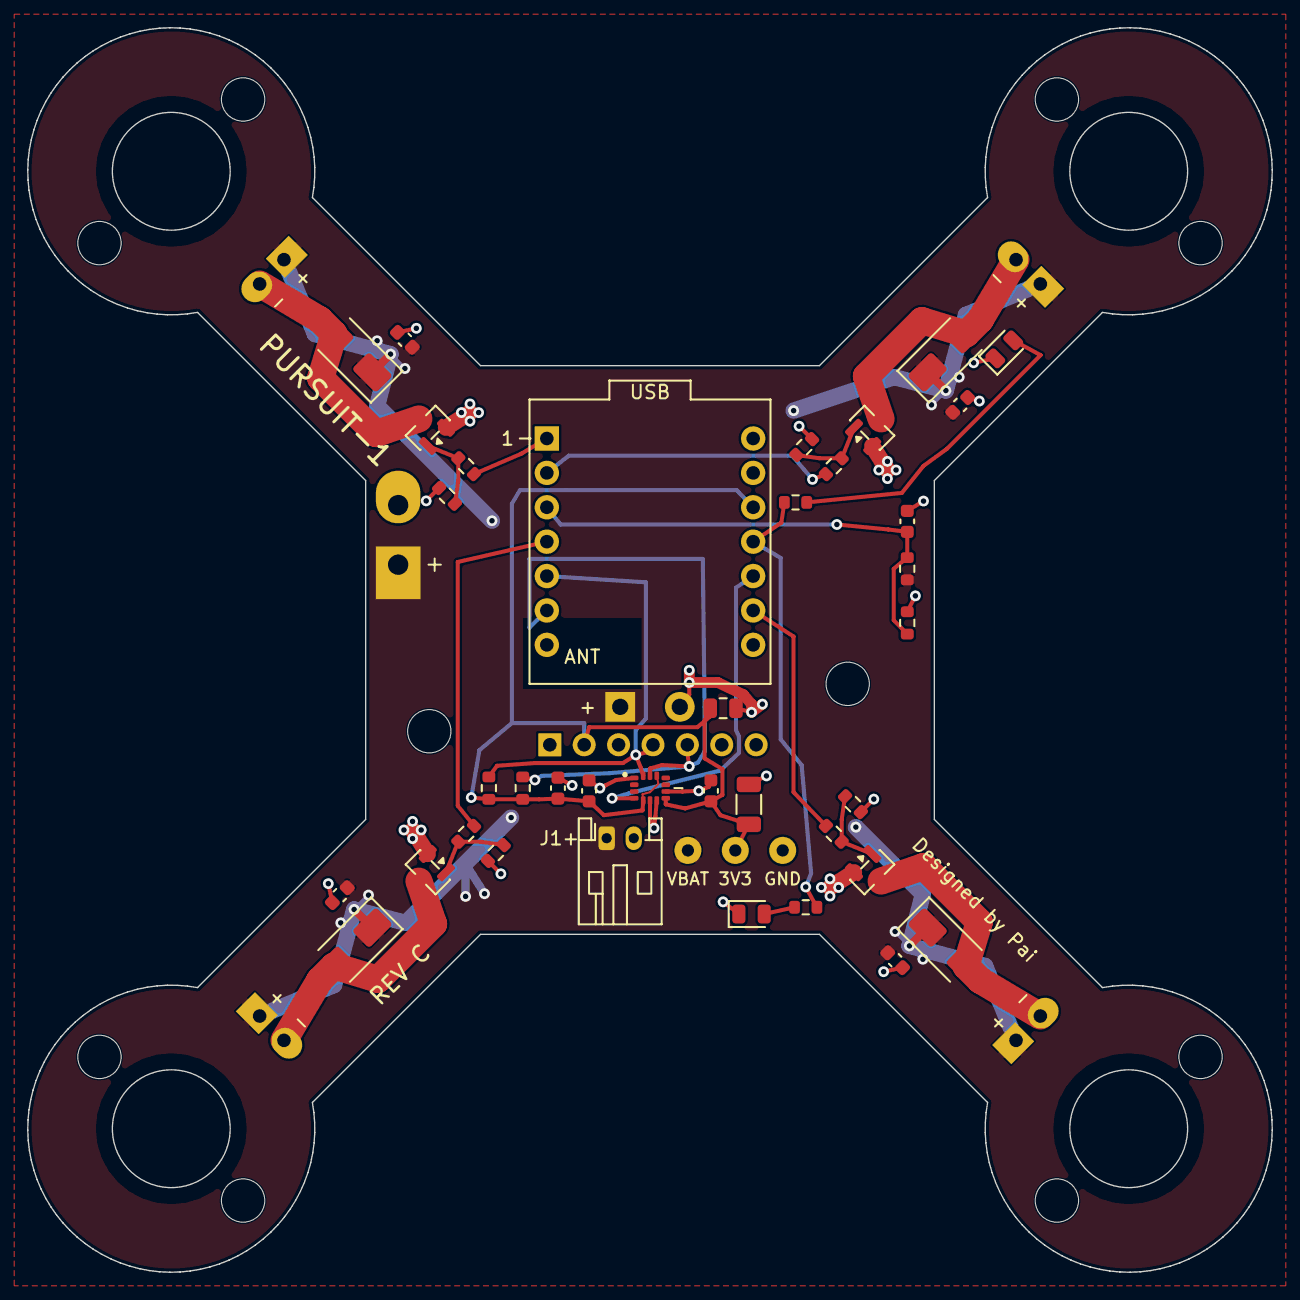
[picture p24: board pursuit.kicad_pcb from above]

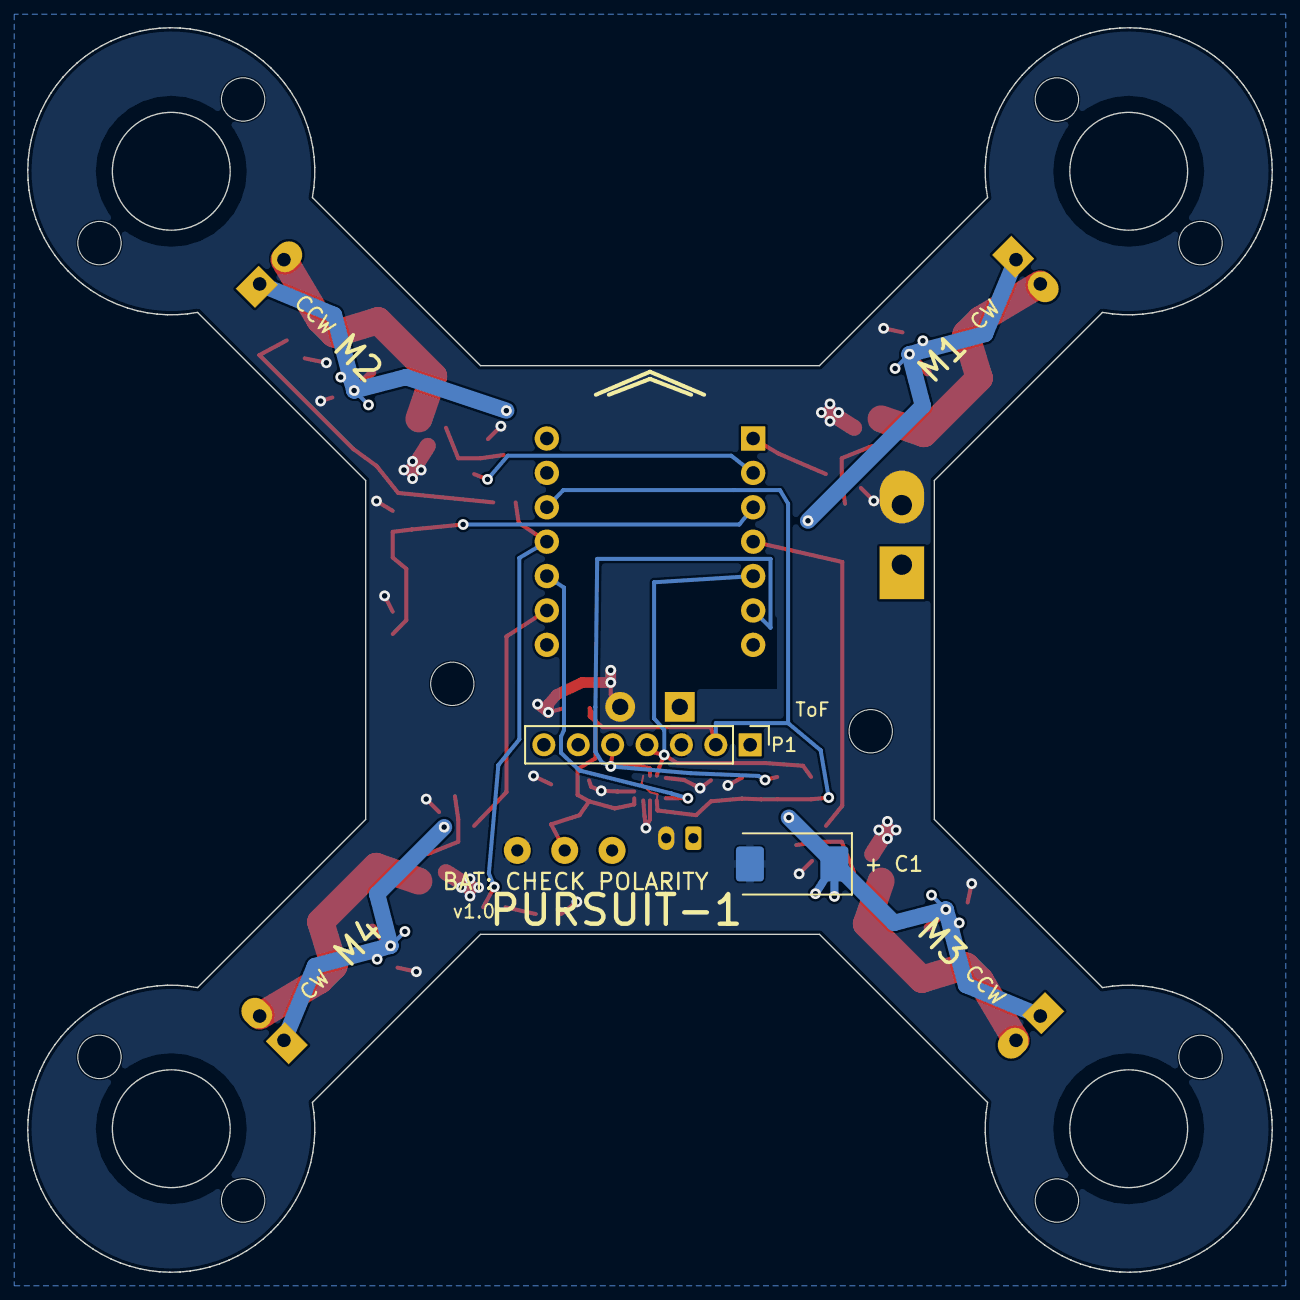
[picture p25: board pursuit.kicad_pcb from below]

Board: 4 copper layers, 91.9 x 91.9 mm, 58 parts (2 on the bottom side), 22 nets.

Other parts of the board:
H1, H2, H3, H4, H5, H6, H7, H8, H9, H10: Strap_Hole_3.2
