DerKodex-Repo-Curator/pursuit-drone/firmware/include/config.h

/* PURSUIT-1 board configuration.
 *
 * Pin numbers are the ESP32-S3 GPIO numbers, taken from scripts/design.py —
 * which is the canonical netlist the PCB was generated from. The XIAO silk
 * labels (D0, D1, ...) are given alongside because that is what is printed on
 * the module, and they are NOT the same numbers.
 *
 * If design.py changes, change this file. There is no automatic link between
 * them, so a mismatch here means the firmware drives the wrong motor and the
 * aircraft flips on take-off.
 */
#ifndef PURSUIT_CONFIG_H
#define PURSUIT_CONFIG_H

#include <stdint.h>

/* ---- motors -------------------------------------------------------------
 * X-quad layout seen from above, USB-C edge forward:
 *
 *      M1 (FL, CW)      M2 (FR, CCW)
 *              \        /
 *               \      /
 *                +----+          front = USB-C
 *               /      \
 *              /        \
 *      M3 (RL, CCW)     M4 (RR, CW)
 *
 * Diagonal pairs spin the same way, which is the standard X pattern: it makes
 * the net torque cancel in hover and lets a torque imbalance produce yaw.
 * The belly silkscreen marks each position AND its required rotation — the
 * firmware mix and the fitted motors must agree or yaw runs away.
 */
#define PIN_M1_PWM   1   /* D0  */
#define PIN_M2_PWM   2   /* D1  */
#define PIN_M3_PWM   4   /* D3  */
#define PIN_M4_PWM   7   /* D8  */

/* ---- sensors ------------------------------------------------------------ */
#define PIN_SDA      5   /* D4  — XIAO default SDA */
#define PIN_SCL      6   /* D5  — XIAO default SCL */
#define PIN_IMU_INT  8   /* D9  — ICM-42688-P INT1, open-drain */

#define I2C_ADDR_IMU   0x68  /* AD0 tied low on the board */
#define I2C_ADDR_TOF   0x29  /* VL53L1X default */
#define I2C_ADDR_BARO  0x77  /* BMP390, 0x76 if SDO is pulled low */
#define I2C_FREQ_HZ    400000

/* ---- battery ------------------------------------------------------------
 * Divider is 1:1, so the ADC sees half the pack voltage. GPIO3 is ADC1_CH2
 * and also a strap pin — high-Z at reset is fine, which is why it was chosen.
 *
 * REV B changed the resistors 100k/100k -> 10k/10k. VBAT_DIVIDER is unchanged
 * at 2.0 because the RATIO is unchanged; what changed is the source impedance
 * the ADC sees, 50 kOhm -> 5 kOhm. See VBAT_SANE_MIN_V below for why that
 * mattered. This firmware runs correctly on both boards.
 */
#define PIN_VBAT_SENSE 3   /* D2 */
#define VBAT_DIVIDER   2.0f
#define ADC_VREF       3.3f

/* ---- indicators --------------------------------------------------------- */
#define PIN_LED_CTRL 9   /* D10 — BOTH LEDs share this pin */

/* ---- PWM ----------------------------------------------------------------
 * 32kHz is above audio and comfortably inside the AO3400A's switching
 * ability, while staying low enough that gate-charge losses do not dominate
 * at 1S. 8-bit resolution is all a brushed motor can use.
 */
#define MOTOR_PWM_FREQ_HZ  32000
#define MOTOR_PWM_BITS     8
#define MOTOR_PWM_MAX      ((1 << MOTOR_PWM_BITS) - 1)

/* ---- loop rates --------------------------------------------------------- */
#define LOOP_HZ        1000   /* attitude control */
#define TOF_HZ         30     /* VL53L1X long-range mode caps out near here */
#define BARO_HZ        50     /* BMP390 ODR — comfortably above the alt loop */
#define TELEM_HZ       20
#define BATT_HZ        50

/* ---- flight limits ------------------------------------------------------
 * Deliberately conservative: this airframe has T:W around 1.6 once pack sag
 * is accounted for, so there is little authority to spare.
 */
#define MAX_ANGLE_DEG      25.0f
#define MAX_YAW_RATE_DPS   180.0f
#define MIN_SPIN_THROTTLE  0.06f  /* keeps motors turning so control is live */
#define MAX_THROTTLE       0.95f  /* leave headroom for attitude correction */

/* ---- altitude ceiling ---------------------------------------------------
 * The aircraft must never be commandable above the height it can actually
 * MEASURE, and only this side knows which sensors are physically fitted. The
 * laptop asks for a height; the firmware decides whether that height is
 * observable and clamps it if not.
 *
 * Without a barometer, altitude hold goes blind somewhere past the VL53L1X's
 * 3.5 m — and the failure is quiet, because losing the floor degrades to
 * open-loop throttle rather than to an error. The aircraft then holds
 * whatever throttle it last learned, at whatever height it happened to lose
 * the reading, and drifts. So the rangefinder-only ceiling sits at 2.5 m,
 * well inside the sensor's honest range with the tilt correction applied.
 *
 * With the BMP390 fitted the ceiling is 9.5 m — a shade over 30 ft. Not a
 * physical limit; a deliberate one, because this is a 92 mm airframe with no
 * GPS, and beyond visual judgement of its attitude there is nothing to fly by.
 */
#define ALT_CEILING_TOF_M   2.50f
#define ALT_CEILING_BARO_M  9.50f

/* ---- sensor loss ---------------------------------------------------------
 * How long the attitude estimate may be stale before flying on it is
 * unrecoverable. Flying on a frozen estimate means the PID holds whatever
 * correction it last computed while the aircraft drifts out from under it.
 *
 * A DURATION, not a count of failed reads. It was a count of 50, justified in
 * the comment as "~50ms on a 1kHz bus" — which silently assumed the reads
 * stay fast. Measured on hardware: a read against a dead I2C bus BLOCKS for
 * about 7.5ms waiting for a timeout, so the loop drops to ~130Hz and 50
 * failures takes ~375ms, not 50. Seven times longer flying blind than
 * intended, and the failure mode that makes reads slow is the same one that
 * makes them fail.
 */
#define IMU_LOSS_TIMEOUT_S  0.05f

/* ---- camera exposure -----------------------------------------------------
 * Two stops apart, because flight and bench want opposite things. See
 * camera.h. The flight value is what boots; the bench value is reachable only
 * from the serial console, and only while the aircraft is not flying.
 */
#define CAM_AE_LEVEL_FLIGHT  (-2)
#define CAM_AE_LEVEL_BENCH   (2)

/* ---- radio link ----------------------------------------------------------
 * CHANNEL. softAP() with no channel lands on 1, which in any built-up area is
 * the most congested of the three non-overlapping 2.4GHz channels (1, 6, 11).
 * Outdoors the limit on this link is almost never transmit power — it is other
 * people's networks — so picking a quiet channel buys more usable range than
 * anything else free. 6 is the middle one and the least likely to sit under a
 * neighbouring router's skirts. Change it if a scan shows 6 is busy where you
 * fly; the laptop follows the AP, so nothing else needs to know.
 *
 * TX POWER. The Arduino default is already at or near maximum, so setting it
 * explicitly buys little — but it removes a silent dependency on whatever the
 * core happens to default to this release.
 */
#define WIFI_AP_CHANNEL   6

/* How long to wait for an existing network before giving up and hosting the
 * SoftAP. Only used when PURSUIT_STA_SSID is defined in secrets.h. Long enough
 * for a normal DHCP join, short enough that a bench boot with the router off
 * is not a noticeable wait. */
#define PURSUIT_STA_TIMEOUT_MS  8000
#define WIFI_TX_POWER     WIFI_POWER_19_5dBm

/* ---- video bitrate vs range ----------------------------------------------
 * The video stream is ~1.6 Mbps; the command packets are ~7 kbps. Video is
 * 200x heavier and is what collapses first as range opens up, taking the
 * framerate and the latency with it.
 *
 * RANGE mode trades resolution for link margin. MEASURED on the live stream,
 * 2026-08-16: SVGA q12 2.61 Mbps -> VGA q26 1.70 Mbps, a 35% saving, at an
 * unchanged ~25 fps. It costs face recognition, which past 3.4 m does not work
 * anyway — so at the distance where you would want this, you are spending
 * bandwidth on something you cannot use.
 *
 * Deliberately a runtime toggle, not a new default: the close-in work that
 * the aircraft is actually FOR needs SVGA, and a reboot must come back ready
 * for it.
 */
#define CAM_QUALITY_CLOSE  12
#define CAM_QUALITY_RANGE  26

/* ---- battery protection -------------------------------------------------
 * The XIAO's 3V3 comes from an SGM6029C buck that drops out around 3.5V in.
 * SPICE puts the pack at 3.61V during a four-motor full-throttle burst with
 * an optimistic 60mR source model, so a real cell is worse. Without a limiter
 * the flight controller browns out in the air.
 */
/* Below this the sample is the ADC lying, not the pack.
 *
 * Measured 2026-08-20: with motor PWM running, the ADC returned 1.70 V at 0%
 * duty and 0.00 V during a sustained run — while the board was demonstrably
 * alive and printing those very numbers over serial. Neither is physically
 * reachable: the XIAO's buck needs 1.95 V in and cannot boost, so at 1.70 V
 * there is no 3V3 rail and no firmware running to report anything.
 *
 * Cause is the sense divider. 100k/100k is a 50 kOhm source into an ADC whose
 * sample-and-hold wants well under 10 kOhm; it barely settles when quiet, and
 * 32 kHz motor switching nearby finishes it off. The divider was sized for
 * low idle draw and paid for it in measurement integrity.
 *
 * FIXED IN HARDWARE ON REV B: 10k/10k, a 5 kOhm source, inside what the S3's
 * sample-and-hold needs. The rejection below is KEPT anyway — it costs one
 * comparison, it is the only thing standing between a corrupted sample and a
 * throttle clamp, and this firmware still has to run on a rev A board.
 *
 * 2.50 V, not 3.00: a genuinely collapsing pack must still be visible. This
 * rejects the impossible, not the alarming. Anything above it is believed. */
#define VBAT_SANE_MIN_V   2.50f

#define VBAT_CRITICAL_V   3.40f  /* land now */
#define VBAT_LOW_V        3.60f  /* start clamping throttle */
#define VBAT_NOMINAL_V    3.85f  /* full authority above this */
#define VBAT_FULL_V       4.20f

/* ---- IMU mounting orientation -------------------------------------------
 * The flight maths runs in the FLU body frame: +X forward (USB-C edge),
 * +Y LEFT, +Z up, right-handed — see src/frame.h. Whether the ICM-42688-P's
 * own axes deliver that depends on how the chip sits on the PCB, which no
 * amount of desk reasoning settles. These macros remap sensor axes into the
 * body frame in one place; the bench 'o' test is the ground truth that
 * validates them BEFORE any flight:
 *
 *     tilt the RIGHT edge down  -> roll must read POSITIVE
 *     tilt the NOSE down        -> pitch must read POSITIVE
 *
 * If either sign is wrong, fix it HERE (swap/negate), never in the filter.
 * The same mapping applies to gyro and accel — any rigid mounting is a
 * permutation with signs, identical for both.
 */
/* Determined on real hardware via the bench 'o' test, 2026-08-18: the fitted
 * ICM-42688-P sits rotated 180 deg in yaw relative to the USB-C-forward body
 * frame. Flat reads +1g on Z (up is correct), but right-edge-down gave
 * NEGATIVE roll and nose-down gave NEGATIVE pitch with the identity map -- both
 * backwards, which flips the aircraft on take-off. A 180 deg yaw is X->-X,
 * Y->-Y, Z unchanged, applied identically to accel and gyro. Re-verified after
 * the change: right-edge-down -> +roll, nose-down -> +pitch. */
#define IMU_ORIENT_X(x, y, z) (-(x))
#define IMU_ORIENT_Y(x, y, z) (-(y))
#define IMU_ORIENT_Z(x, y, z) (z)

#endif /* PURSUIT_CONFIG_H */
