DerKodex-Repo-Curator/pursuit-drone/firmware/src/flight_state.cpp

#include "flight_state.h"

#include <cmath>
#include <cstring>

#include "config.h"

namespace {

/* Silence long enough that the command stream is genuinely gone rather than
 * one dropped packet. At the pump's 30Hz this is ~12 missed packets. */
constexpr uint32_t LINK_TIMEOUT_MS = PURSUIT_LINK_TIMEOUT_MS;
/* Still silent this long and the aircraft puts itself down. */
constexpr uint32_t LAND_TIMEOUT_MS = 3000;

/* How long LANDING is allowed to last before the motors are cut.
 *
 * LANDING had no exit at all until 2026-08-19: disarm() had zero callers in
 * src/, there was no timeout and no landed-detection, so every one of the
 * three paths into it (link silence past LAND_TIMEOUT_MS, a deliberate disarm
 * in flight, IMU loss) parked the aircraft in a state it could never leave.
 * It would descend under the throttle cap in main.cpp and then sit on the
 * ground with the props turning until the pack was flat.
 *
 * Two seconds, not ten. The descent runs at hover*0.80, and under that cap
 * this airframe reaches the ground from any height it can legally hold long
 * before ten seconds are up — a ten-second timer would just be ten seconds of
 * props spinning on the floor.
 *
 * Deliberately elapsed time in state and not a landed detector: the obvious
 * detector (fused height near zero and climb rate settled) is blind on this
 * board, because the ToF is NOT FITTED and alt_hold.cpp freezes climb_ms_
 * whenever have_height is false. It would go quiet at exactly the moment it
 * had to fire. A dumb timer cannot be fooled by a missing sensor.
 */
constexpr uint32_t LANDING_TIMEOUT_MS = 2000;

float clampf(float v, float lo, float hi)
{
    if (!std::isfinite(v)) return 0.0f;
    return v < lo ? lo : (v > hi ? hi : v);
}

}  /* namespace */

FlightState::FlightState()
    : state_(PURSUIT_STATE_BOOT),
      last_cmd_ms_(0),
      last_cmd_t_ms_(0),
      last_seq_(0),
      have_seq_(false),
      sensors_ok_(false),
      setpoint_{},
      landing_since_ms_(0),
      landing_timing_(false),
      accepted_(0),
      rejected_(0),
      stale_(0)
{
}

void FlightState::enter(uint8_t s)
{
    if (state_ == s) return;
    state_ = s;

    /* Leaving any powered state neutralises the setpoint. Whatever the
     * aircraft was told to do a moment ago is not a safe default for what
     * comes next. */
    if (s == PURSUIT_STATE_IDLE || s == PURSUIT_STATE_FAILSAFE ||
        s == PURSUIT_STATE_LANDING) {
        setpoint_.roll_deg = 0.0f;
        setpoint_.pitch_deg = 0.0f;
        setpoint_.yaw_rate_dps = 0.0f;
        setpoint_.locked = false;
    }
}

void FlightState::sensors_ready()
{
    sensors_ok_ = true;
    if (state_ == PURSUIT_STATE_BOOT) enter(PURSUIT_STATE_IDLE);
}

void FlightState::disarm()
{
    have_seq_ = false;
    enter(PURSUIT_STATE_IDLE);
}

void FlightState::emergency_land()
{
    /* BOOT is not a flying state to be landed from — it is the gate that says
     * the sensors have NOT passed, and a fault must never move the aircraft
     * forward through the state machine.
     *
     * Observed on hardware 2026-08-11: a bare XIAO has no battery divider, so
     * VBAT reads 0.00V, the limiter latches critical, and this was called at
     * 50Hz. The aircraft reported IDLE over telemetry while the boot banner
     * insisted it was held in BOOT. Arming was still correctly refused —
     * that gate is `sensors_ok_`, which is independent of the state — but
     * every downstream reader (telemetry, the HUD's AIRCRAFT panel) was being
     * told the sensors had passed when they had not. */
    if (state_ == PURSUIT_STATE_BOOT) return;

    /* LANDING is in this list because this call is REPEATED, not one-shot.
     * Found by inspection 2026-08-19: main.cpp calls emergency_land() on
     * every battery tick (50Hz) while critical() is true, and critical()
     * LATCHES — battery.cpp never clears it, and Battery::reset() is only
     * called from setup(). With LANDING missing from this list the second
     * call fell through to the else and drove LANDING -> IDLE, which clears
     * motors_enabled() and cuts the motors. So a flat pack gave exactly ONE
     * 20 ms tick of controlled descent and then dropped the aircraft — this
     * function turning into the fall it exists to prevent. The same one-tick
     * cut applied to the repeated IMU-loss call.
     *
     * Already landing is already the correct response to a new fault; the
     * state must be sticky against a fault that keeps re-reporting itself.
     * LANDING's own exit is the timeout in tick(), not this. */
    if (state_ == PURSUIT_STATE_ARMED || state_ == PURSUIT_STATE_FLYING ||
        state_ == PURSUIT_STATE_FAILSAFE || state_ == PURSUIT_STATE_LANDING) {
        enter(PURSUIT_STATE_LANDING);
    } else {
        enter(PURSUIT_STATE_IDLE);
    }
}

bool FlightState::on_packet(const uint8_t *buf, uint32_t len, uint32_t now_ms)
{
    /* Validation before anything else touches the payload: length, magic,
     * version, CRC and finiteness are all checked by pursuit_cmd_valid(). */
    if (!pursuit_cmd_valid(buf, len)) {
        rejected_++;
        return false;
    }

    pursuit_cmd_t cmd;
    std::memcpy(&cmd, buf, sizeof(cmd));

    /* Reordered or replayed. UDP does both, and acting on an old setpoint is
     * indistinguishable from acting on a wrong one. */
    if (have_seq_ && !pursuit_seq_newer(cmd.seq, last_seq_)) {
        stale_++;
        return false;
    }

    last_seq_ = cmd.seq;
    have_seq_ = true;
    last_cmd_ms_ = now_ms;
    last_cmd_t_ms_ = cmd.t_ms;
    accepted_++;

    const bool armed_request = (cmd.flags & PURSUIT_FLAG_ARMED) != 0;
    const bool failsafe = (cmd.flags & PURSUIT_FLAG_FAILSAFE) != 0;

    setpoint_.roll_deg = clampf(cmd.roll, -MAX_ANGLE_DEG, MAX_ANGLE_DEG);
    setpoint_.pitch_deg = clampf(cmd.pitch, -MAX_ANGLE_DEG, MAX_ANGLE_DEG);
    setpoint_.yaw_rate_dps =
        clampf(cmd.yaw_rate, -MAX_YAW_RATE_DPS, MAX_YAW_RATE_DPS);
    setpoint_.alt_hold = (cmd.flags & PURSUIT_FLAG_ALT_HOLD) != 0;
    setpoint_.alt_sp_m = cmd.alt_sp;
    setpoint_.locked = (cmd.flags & PURSUIT_FLAG_LOCKED) != 0;

    if (!sensors_ok_) return true;   /* stay in BOOT until sensors pass */

    /* --- authority ------------------------------------------------------
     * The arm bit must be present on THIS packet. It is a held control on
     * the operator's side, so it must be a held condition here too; treating
     * it as a latch would mean one packet licences unlimited flight.
     */
    if (!armed_request) {
        if (state_ == PURSUIT_STATE_FLYING) {
            /* Disarming in the air is a deliberate abort, so descend under
             * control rather than cutting motors and dropping it. */
            enter(PURSUIT_STATE_LANDING);
        } else if (state_ != PURSUIT_STATE_LANDING) {
            enter(PURSUIT_STATE_IDLE);
        }
        return true;
    }

    if (failsafe) {
        /* The laptop is alive but cannot see the target. Hold, do not steer.
         * Distinct from silence, which eventually lands. */
        setpoint_.roll_deg = 0.0f;
        setpoint_.pitch_deg = 0.0f;
        setpoint_.yaw_rate_dps = 0.0f;
        if (state_ == PURSUIT_STATE_FLYING || state_ == PURSUIT_STATE_ARMED) {
            enter(PURSUIT_STATE_FAILSAFE);
        }
        return true;
    }

    switch (state_) {
    case PURSUIT_STATE_IDLE:
        /* Refuse to arm on a pack that is already flat.
         *
         * Without this, a latched-critical battery gives a ~2s oscillation:
         * an arm packet takes IDLE -> ARMED, the next battery tick drives
         * ARMED -> LANDING, the LANDING timeout disarms back to IDLE, and the
         * still-held arm button starts it again. Motors spin for a couple of
         * seconds each cycle, on the one pack that can least afford it.
         *
         * critical() is driven by the SLOW (2s) filtered voltage and latches,
         * so a momentary sag under a throttle burst cannot trip this — only a
         * pack that genuinely sits low. It clears on Battery::reset(), which
         * runs in setup(); swapping the pack power-cycles the board anyway.
         *
         * Deliberately gated here and not in emergency_land(): this may only
         * ever REFUSE to arm. A gate that can be talked into permitting
         * something is not a safety gate. */
        if (batt_critical_) {
            rejected_++;
            break;
        }
        enter(PURSUIT_STATE_ARMED);
        break;
    case PURSUIT_STATE_ARMED: {
        /* Only leave ARMED once actually commanded upward, so that arming
         * on the bench does not read as flight. */
        const bool climbing = setpoint_.alt_hold
            ? (setpoint_.alt_sp_m > 0.15f)
            : (setpoint_.alt_sp_m > MIN_SPIN_THROTTLE);
        if (climbing) enter(PURSUIT_STATE_FLYING);
        break;
    }
    case PURSUIT_STATE_FAILSAFE:
        enter(PURSUIT_STATE_FLYING);   /* recovered */
        break;
    default:
        break;
    }
    return true;
}

void FlightState::tick(uint32_t now_ms)
{
    if (state_ == PURSUIT_STATE_BOOT || state_ == PURSUIT_STATE_IDLE) {
        landing_timing_ = false;
        return;
    }

    /* --- the way out of LANDING -----------------------------------------
     * Timed from the first tick that observes the state rather than from
     * enter(), because enter() has no clock — at loop rate that costs one
     * pass. The clock is started here and NOT in the branch below on purpose:
     * two of the three routes into LANDING (a battery-critical or IMU-loss
     * emergency_land() before the laptop has ever been heard from) leave
     * last_cmd_ms_ at 0, and the guard that follows would return before any
     * timer downstream of it ever ran. A landing timeout that only works if
     * the link once worked is not a timeout.
     *
     * Everything below still runs while landing, so a link that goes silent
     * mid-descent still gets its setpoint zeroed. */
    if (state_ == PURSUIT_STATE_LANDING) {
        if (!landing_timing_) {
            landing_timing_ = true;
            landing_since_ms_ = now_ms;
        } else if ((uint32_t)(now_ms - landing_since_ms_)
                       >= LANDING_TIMEOUT_MS) {
            /* Descent is over: cut. disarm() rather than enter(IDLE) so the
             * sequence number is dropped too — the next flight must not
             * inherit this one's window. */
            disarm();
            return;
        }
    } else {
        landing_timing_ = false;
    }

    if (last_cmd_ms_ == 0) return;

    const uint32_t silent = now_ms - last_cmd_ms_;

    if (silent > LAND_TIMEOUT_MS) {
        enter(PURSUIT_STATE_LANDING);
        return;
    }
    if (silent > LINK_TIMEOUT_MS) {
        /* Level off and hold. Explicitly NOT holding the last command: a
         * stale yaw rate re-applied at loop rate flies a constant-radius
         * circle until something stops it. */
        setpoint_.roll_deg = 0.0f;
        setpoint_.pitch_deg = 0.0f;
        setpoint_.yaw_rate_dps = 0.0f;
        setpoint_.locked = false;
        if (state_ != PURSUIT_STATE_LANDING) enter(PURSUIT_STATE_FAILSAFE);
    }
}

bool FlightState::motors_enabled() const
{
    return state_ == PURSUIT_STATE_ARMED || state_ == PURSUIT_STATE_FLYING ||
           state_ == PURSUIT_STATE_FAILSAFE || state_ == PURSUIT_STATE_LANDING;
}

uint32_t FlightState::silence_ms(uint32_t now_ms) const
{
    if (last_cmd_ms_ == 0) return 0;
    return now_ms - last_cmd_ms_;
}
