DerKodex-Repo-Curator/pursuit-drone/firmware/src/icm42688.h

/* ICM-42688-P 6-axis IMU, I2C.
 *
 * TDK's low-noise successor to the MPU-6000 family. On this board it sits at
 * 0x68 (AD0 tied low on the PCB — never floating, which is why the address is
 * not configurable at runtime) on the same 400kHz bus as the VL53L1X.
 *
 * Configured for 1kHz output on both gyro and accel in Low Noise mode, which
 * is what the 1kHz control loop wants. Full scale is deliberately wide:
 * +/-2000 deg/s and +/-16g. A crash or a hard flick easily exceeds narrower
 * ranges, and a saturated gyro reads a plausible-but-wrong number rather than
 * failing — the attitude estimate then rotates to something arbitrary while
 * the aircraft is already in trouble.
 *
 * Axis convention delivered by this driver is the FLU body frame:
 *   +X forward (USB-C edge), +Y LEFT, +Z up (right-handed — "Y right, Z up"
 *   would be left-handed, and every quaternion identity assumes right-handed;
 *   see src/frame.h). Gyro in deg/s, accel in g.
 *
 * The raw sensor axes pass through the IMU_ORIENT_* macros in config.h on
 * the way out, because the mapping from chip axes to body axes depends on
 * how the package is mounted on the PCB. The bench 'o' test validates the
 * mapping on real hardware before any flight.
 */
#ifndef PURSUIT_ICM42688_H
#define PURSUIT_ICM42688_H

#include <stdint.h>

struct ImuSample {
    float gx, gy, gz;   /* deg/s, bias-corrected */
    float ax, ay, az;   /* g                     */
    float temp_c;
    bool  valid;
};

class Icm42688 {
public:
    Icm42688();

    /* Probe and configure. Returns false if WHO_AM_I is wrong or the bus is
     * dead — the caller must NOT arm in that case. */
    bool begin();

    /* One burst read of the 12-byte accel+gyro block. */
    ImuSample read();

    /* Average the gyro at rest to find its zero offset. Every MEMS gyro has
     * one, it is a few deg/s, and left uncorrected the attitude estimate
     * yaws steadily and the aircraft slowly rotates in hover.
     *
     * Refuses to complete if the board is moving: calibrating while someone
     * is holding it bakes that motion in as the new definition of "still".
     * Returns false if it could not get a quiet window.
     */
    bool calibrate_gyro(uint32_t samples = 1000);

    bool calibrated() const { return calibrated_; }
    void gyro_bias(float out[3]) const;

    uint8_t who_am_i() const { return whoami_; }
    const char *last_error() const { return err_; }

    /* --- bus health ------------------------------------------------------
     * Added 2026-08-19. The bench logged 58 "[E][Wire.cpp:499] requestFrom()"
     * lines in 135 lines of serial output while a motor was spinning, and
     * zero with the motors idle — but that is a count of LOG LINES, not of
     * transactions, so the actual failure RATE was unknown. Nothing in the
     * firmware counted them. Without a rate there is no way to tell whether
     * any fix helped.
     *
     * worst_consecutive_failures() matters more than the total: main.cpp
     * clears g_imu_bad_s on ANY successful read, so an intermittent fault
     * interleaved with successes — exactly the observed pattern — never
     * accumulates toward IMU_LOSS_TIMEOUT_S no matter how bad it gets. The
     * consecutive count is the number that would actually catch it. */
    uint32_t reads() const { return reads_; }
    uint32_t read_failures() const { return read_failures_; }
    uint32_t worst_consecutive_failures() const { return worst_consec_; }
    void reset_bus_stats() { reads_ = read_failures_ = 0;
                             consec_fail_ = worst_consec_ = 0; }

private:
    bool write_reg(uint8_t reg, uint8_t val);
    bool fail_read();
    bool read_regs(uint8_t reg, uint8_t *buf, uint8_t len);

    float gyro_scale_;   /* LSB -> deg/s */
    float accel_scale_;  /* LSB -> g     */
    float bias_[3];
    bool  calibrated_;
    uint8_t whoami_;
    const char *err_;

    /* Default-initialised here rather than in the constructors: there are two
     * (target and host) and neither should have to remember these. */
    uint32_t reads_ = 0;
    uint32_t read_failures_ = 0;
    uint32_t consec_fail_ = 0;
    uint32_t worst_consec_ = 0;
};

#endif /* PURSUIT_ICM42688_H */
