DerKodex-Repo-Curator/pursuit-drone/scripts/gen_jlcpcb.py

"""Emit JLCPCB PCBA files: BOM.csv (their column format) and CPL.csv
(pick-and-place), for TOP-SIDE SMD assembly only.

Deliberately excludes:
  - bottom-side SMD (C1 ONLY since rev C -- C10-C13 moved to the top and ARE
    machine-placed; see VERIFICATION.md s15) and all THT/wire parts, which the
    builder hand-solders;
  - the XIAO module itself (it plugs into headers, it is not a placed part).

Rotation: KiCad's footprint rotation PLUS a per-part correction into JLCPCB's
frame (JLC_ROTATION below). JLCPCB rotates ITS OWN footprint for the LCSC code,
and that footprint's zero is not always KiCad's. Until 2026-09-21 the rotation
was emitted as-is "to be read off the preview"; read off the preview, all four
AO3400A came out 180 degrees round. Every polarised part is still listed in
the ORIENTATION CHECK sheet for verification against JLCPCB's assembly preview.
"""
import csv
import os
import sys

sys.path.insert(0, os.path.dirname(__file__))
import design
import pcbnew

HW = os.path.abspath(os.path.join(os.path.dirname(__file__), "..", "hardware"))
OUT = os.path.abspath(os.path.join(os.path.dirname(__file__), "..", "gerbers"))
OX, OY = 150.0, 100.0

# Degrees to ADD to KiCad's rotation so the part lands the right way round in
# JLCPCB's frame, keyed by LCSC code. Derived, not taken from a community table:
# fit KiCad's footprint pads against JLCPCB's own footprint for that code
# (easyeda.com/api/products/<LCSC>/components) BY PIN FUNCTION, not pad number,
# because the two libraries do not number two-pin parts alike.
#   C20917  AO3400A SOT-23  1=G 2=S 3=D in both; JLC's footprint fits KiCad's
#           SOT-23 at 180 deg (0.06 mm), next best 270 deg at 1.95 mm. The same
#           JLC footprint (uuid bade9066...) is why the RL car's Q1 carries +180.
#           Confirmed on JLCPCB's own preview 2026-09-21: uncorrected, the pin-1
#           dot sat OUTBOARD on Q1-Q4, where this board puts the single drain pin.
#   C8678 SS34, C84256 red LED, C1850418 ICM-42688-P: fit at 0 deg, preview agrees.
#   C84261 yellow LED: pads fit at 180 deg BY NUMBER, but JLC numbers the ANODE
#           as pin 1 and KiCad the cathode, so by function it is 0. Preview agrees.
JLC_ROTATION = {"C20917": 180.0}

# LCSC part numbers. Only fill in codes that have been verified against a
# live LCSC/JLCPCB listing — a wrong code silently fits the wrong part.
# Verified against live LCSC / JLCPCB parts listings (Aug 2026).
LCSC = {
    "Q": ("C20917", "AO3400A"),
    "D": ("C8678", "SS34"),
    "R1": ("C22775", "100R"), "R2": ("C22775", "100R"),
    "R3": ("C22775", "100R"), "R4": ("C22775", "100R"),
    # 1k, not 10k: bounds the gate below threshold even against an
    # unexpected ~45k pull-up on a PWM pin. See design.py.
    "R5": ("C21190", "1k 0603 1% 0603WAF1001T5E"),
    "R6": ("C21190", "1k 0603 1% 0603WAF1001T5E"),
    "R7": ("C21190", "1k 0603 1% 0603WAF1001T5E"),
    "R8": ("C21190", "1k 0603 1% 0603WAF1001T5E"),
    "R9": ("C23162", "4.7k"), "R10": ("C23162", "4.7k"),
    # Rev B: 10k, was 100k -- see design.py for why (50kOhm source into the
    # S3 ADC produced a fake, perfectly linear "battery sag"). Verified
    # 2026-08-21 against the JLCPCB catalogue: C25804 = 0603WAF1002T5E,
    # UNI-ROYAL, 10k +-1% 0603, Basic. Same series as every other resistor
    # here (C21190 = ...1001T5E 1k, C22808 = ...1500T5E 150R), which is the
    # cross-check that matters -- the part number differs from the 100k it
    # replaces (C25803) by one digit, and one digit is the whole error.
    # Snapshot showed 0 stock, which for the most common resistor value in
    # existence reads as a stale snapshot; re-check stock at order time.
    # STOCK: LIVE-VERIFIED 2026-08-30 -- LCSC shows 1,136,900 in stock at
    # $0.0025/ea. The snapshot's ZERO was stale, as suspected. The cart is
    # still the final word at order time, but this is no longer a blocker.
    #
    # If it really is out: C2906982 (FRC0603F1002TS) is a drop-in. Verified
    # identical spec against the same catalogue -- 100mW, 10kOhm, 75V, thick
    # film, +-1%, +-100ppm/C, 0603 -- with 10.3M in stock. It is EXTENDED, so
    # it costs one $3 setup fee, and it is the only line on this BOM that
    # would move. Do NOT substitute C23192: it looks adjacent by part number
    # and is 510k, which would put 4.2V straight onto the ADC pin.
    "R11": ("C25804", "10k 0603 1% 0603WAF1002T5E"),
    "R12": ("C25804", "10k 0603 1% 0603WAF1002T5E"),
    "U2": ("C1850418", "ICM-42688-P"),
    "C2": ("C57112", "10nF 0603 X7R 50V"),
    "C3": ("C14663", "100nF 0603 X7R 50V"),
    "C8": ("C14663", "100nF 0603 X7R 50V"),
    # rev C: C10-C13 moved from the BELLY to the top face, so they are
    # machine-placed now and need a code. Same verified 100nF 0603 X7R
    # as C3 and C8 -- design.py asks for 16V, this is the 50V part, which
    # is the same footprint and strictly more margin on a 4.2V rail.
    **{f"C{i}": ("C14663", "100nF 0603 X7R 50V") for i in (10, 11, 12, 13)},
    "C4": ("C23630", "2.2uF 0603 X5R 16V"),
    "C6": ("C45783", "22uF 0805 X5R 25V"),
    "C7": ("C15008", "100uF 1206 X5R 6.3V"),
    "R13": ("C22808", "150R 0603 1% 0603WAF1500T5E"),
    "R14": ("C22808", "150R 0603 1% 0603WAF1500T5E"),
    "LED1": ("C84261", "LED 0805 yellow NCD0805Y1 Vf1.6-2.6V"),
    "LED2": ("C84256", "LED 0805 red NCD0805R1 Vf1.6-2.6V"),
}
PENDING = "TBD"          # filled from the sourcing agent's verified results

# Parts whose orientation is fatal if rotated 180 deg.
POLARISED = {
    "D": "SS34 SMA — CATHODE (banded end) must face VBAT, i.e. INBOARD "
         "toward the board centre along the arm.",
    "LED": "LED 0805 — cathode to GND. On this board GND is the pad nearer "
           "the board centre.",
    "Q": "AO3400A SOT-23 — pin1=Gate, pin2=Source, pin3=Drain. The single "
         "pin (Drain) faces OUTBOARD along the arm.",
    "U2": "ICM-42688-P LGA-14 — pin 1 dot is at the board's FRONT-LEFT of "
          "the package (silk dot marks it). A 90 or 180 error here also "
          "silently rotates the gyro axes.",
}


def main():
    b = pcbnew.LoadBoard(os.path.join(HW, "pursuit.kicad_pcb"))
    bom_rows, cpl_rows, check_rows, missing = [], [], [], []

    for fp in sorted(b.GetFootprints(), key=lambda f: f.GetReference()):
        ref = fp.GetReference()
        if ref.startswith("H") or ref not in design.COMPONENTS:
            continue
        pads = list(fp.Pads())
        if any(p.GetAttribute() == pcbnew.PAD_ATTRIB_PTH for p in pads):
            continue                      # THT: hand-soldered
        if fp.IsFlipped():
            continue                      # bottom side: hand-soldered
        comp = design.COMPONENTS[ref]
        if comp.get("dnf"):
            continue                      # pads only — see design.py
        key = ref if ref in LCSC else ref.rstrip("0123456789")
        code, _ = LCSC.get(key, (PENDING, ""))
        if code == PENDING:
            missing.append(f"{ref} ({comp['value']})")
        pos = fp.GetPosition()
        # ABSOLUTE page coordinates, Y negated — exactly what KiCad's own
        # position-file export emits, and therefore the same origin the
        # Gerbers use. Subtracting the board-centre offset here put every
        # part 150mm off the board in JLCPCB's viewer.
        x = pcbnew.ToMM(pos.x)
        y = -pcbnew.ToMM(pos.y)
        rot = fp.GetOrientationDegrees() % 360
        jlc_rot = (rot + JLC_ROTATION.get(code, 0.0)) % 360
        bom_rows.append([comp["value"], ref, comp["footprint"], code])
        cpl_rows.append([ref, f"{x:.4f}", f"{y:.4f}", "Top", f"{jlc_rot:.2f}"])
        # Match the polarity rule on the DESIGNATOR FAMILY, never on the
        # LCSC key — adding an explicit per-part code once changed `key`
        # from "LED" to "LED1" and both LEDs silently vanished from the
        # orientation checklist.
        fam = ref.rstrip("0123456789")
        for pk, note in POLARISED.items():
            if fam == pk or ref == pk:
                check_rows.append([ref, comp["value"], f"{rot:.1f}", note])

    # merge BOM rows that share value+footprint+code (JLCPCB wants one line
    # per distinct part, designators comma-joined)
    merged = {}
    for val, ref, fpn, code in bom_rows:
        merged.setdefault((val, fpn, code), []).append(ref)
    with open(os.path.join(OUT, "JLCPCB_BOM.csv"), "w", newline="") as f:
        w = csv.writer(f)
        w.writerow(["Comment", "Designator", "Footprint", "LCSC Part #"])
        for (val, fpn, code), refs in sorted(merged.items(),
                                             key=lambda kv: kv[1][0]):
            w.writerow([val, ",".join(sorted(refs)), fpn, code])
    with open(os.path.join(OUT, "JLCPCB_CPL.csv"), "w", newline="") as f:
        w = csv.writer(f)
        w.writerow(["Designator", "Mid X", "Mid Y", "Layer", "Rotation"])
        w.writerows(sorted(cpl_rows))
    with open(os.path.join(OUT, "ORIENTATION_CHECK.csv"), "w", newline="") as f:
        w = csv.writer(f)
        w.writerow(["Designator", "Value", "KiCad rotation",
                    "What to confirm on JLCPCB's preview render"])
        w.writerows(sorted(check_rows))

    print("LCSC map (verify value AND package against JLCPCB's match):")
    for (val, fpn, code), refs in sorted(merged.items(), key=lambda kv: kv[1][0]):
        exp = next((d for k, (c, d) in LCSC.items() if c == code), "")
        print(f"   {','.join(sorted(refs)):14s} {val:26s} {fpn:22s} {code:10s} {exp}")
    print()
    print(f"assembled parts   : {len(cpl_rows)}")
    print(f"distinct BOM lines: {len(merged)}")
    print(f"polarised to check: {len(check_rows)}")
    if missing:
        print(f"LCSC # STILL NEEDED ({len(missing)}): {', '.join(missing)}")
    else:
        print("LCSC #: complete")


if __name__ == "__main__":
    main()
