DerKodex-Repo-Curator/pursuit-drone/(commit log)

2026-08-10 Initialise repository
    Import of PURSUIT-1, a person-following micro-quadcopter whose PCB is its own
    airframe. The work in this first set of commits was developed between July and
    August 2026 without version control; it is imported here in subsystem-sized
    pieces rather than as one opaque blob, and everything from this point forward
    is committed as it is written.
    Excluded deliberately, see .gitignore:
    - face embeddings and any capture of a real person (biometric data)
    - ~295 MB of ONNX weights, fetched and verified by vision/fetch_models.py
    - manufacturer datasheets, replaced by links in docs/vendor/SOURCES.md
    - the SoftAP passphrase, moved to a gitignored header
2026-08-10 hardware: PCB-as-airframe, generated from a canonical netlist
    The board is the aircraft: a 2-layer 1.6mm FR4 X-frame, 100mm wheelbase,
    91.91mm square, carrying the whole flight electronics with no separate chassis.
    Nothing here is drawn by hand. scripts/design.py is the single source of truth
    for the netlist; gen_pcb.py and gen_sch.py emit the board and schematic from it
    via the pcbnew API, routes.py holds explicit routing tables, and footprints.py
    emits the custom footprints. Editing the design means editing Python and
    regenerating, which is why the schematic cannot silently disagree with the
    board.
    Ordering is gated rather than eyeballed. scripts/preflight.py must exit zero
    before fabric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
    [BOM.csv, JLCPCB_BOM.csv, ORIENTATION_CHECK.csv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]
2026-08-10 firmware: ESP32-S3 flight stack, host-testable
    IMU -> Madgwick -> angle PID -> rate PID -> mixer -> phase-staggered PWM at
    1 kHz, plus VL53L1X altitude hold, battery sag limiting, a link watchdog and a
    PSRAM blackbox logger.
    Split into two PlatformIO environments on purpose. Everything safety-critical
    is written without Arduino headers so it compiles and is tested on a laptop:
    the mixer, the flight state machine, the battery limiter, the attitude filter
    and the PID cascade are all covered by 'pio test -e native'. Only the hardware
    wiring needs a board.
    Three things in here were bugs found by testing rather than by reading:
    - the body frame is FLU, so a clockwise yaw reads gz NEGATIVE. Fe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
    [alt_hold.cpp, alt_hold.h, battery.cpp, battery.h, benchtest.cpp, benchtest.h, blackbox.cpp, blackbox.h]
2026-08-10 vision: off-board person-following perception and control
    Runs on the laptop, not the aircraft. Frame -> YOLO11n person detection ->
    ByteTrack -> SCRFD face -> ArcFace 512-d embedding -> person ReID -> a
    four-state lock machine -> PD visual servo -> CRC'd UDP. ~25 fps, 38.7 ms mean.
    ONNX Runtime and CoreML throughout, with no torch or ultralytics. Forced
    originally by this machine running Python 3.14, which has no torch wheels, and
    kept because it is 40 MB instead of 2.5 GB, runs on the ANE, and ports to a Pi.
    Identity is two signals doing different jobs, which is the part that took the
    longest to get right. The face ACQUIRES and re-confirms and is strict; body
    ReID only SUSTAINS. The appe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
2026-08-10 docs: design notes, verification record, and third-party provenance
    docs/DESIGN.md and docs/VERIFICATION.md carry the reasoning and the evidence.
    Adds two provenance files so every borrowed thing is attributed at the point of
    use rather than in a blanket disclaimer:
    - docs/vendor/SOURCES.md links each manufacturer datasheet instead of
    redistributing it, and records which specific fact in this repository came
    from which document (the ICM-42688-P register map and its big-endian word
    order, the SGM6029 output-capacitance limit behind the DNF pads, the camera
    pins from the XIAO Sense schematic, and the D8/D9/D10 microSD conflict that
    forced the blackbox into PSRAM).
    - vi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
2026-08-10 firmware: measure the loop rate instead of asserting it
    config.h declares LOOP_HZ 1000. Nothing sampled the real period, so that was
    an intention rather than a fact, and the one statistic the loop did keep —
    iterations per second — is precisely the one that hides the failure that
    matters. A loop running at 2 kHz for 900 ms and then stalling for 100 ms
    reports a healthy 1 kHz mean. Those 100 ms are an aircraft integrating gyro
    rates against a frozen attitude estimate.
    src/loopstats.{h,cpp} keeps the distribution instead: a ten-bucket histogram
    of loop periods weighted around the 1000 us budget, the worst case ever seen,
    percentiles reported conservatively as bucket upper edges, and a cou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
    [benchtest.cpp, benchtest.h, loopstats.cpp, loopstats.h, main.cpp]
2026-08-10 sim: a plant model, and the answer to 'how do you know it is stable'
    Until now that question had the honest answer 'I don't'. Every gain in this
    project is scaled from typical brushed-whoop values and has never touched this
    airframe, and vision/sim_drone.py could not help — it is a link simulator, and
    its altitude dynamics are a first-order lag toward the setpoint, which is a
    plant that is stable by construction.
    sim/flight/ is the smallest model that can answer it: rigid-body rotational
    dynamics with gyroscopic coupling, first-order motor lag, quadratic thrust,
    saturation, and the real three-loop cascade at the real gains.
    THE RESULT. The outer vision loop is closed through the airframe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
2026-08-10 ci: verify the claims on every push, and fix a fresh-clone failure
    Six jobs: the Python vision suite, the closed-loop simulation (tests plus an
    actual sweep run), the firmware host tests, the ESP32-S3 target build, a
    generated-header drift check, and a hygiene gate.
    The drift check is the one worth explaining. firmware/include/pursuit_link.h is
    generated from vision/pursuit/protocol.py so the two ends of the link cannot
    disagree — but a generator is only a guarantee if something verifies it was
    re-run. CI regenerates and diffs; a stale header now fails the build instead of
    being discovered by an aircraft rejecting every packet.
    The hygiene gate refuses a face embedding, a tracked secrets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
2026-08-10 docs: rewrite the README around what a reader needs first
    The engineering was strong and structurally invisible. Three specific faults,
    all fixed here:
    - the repository map omitted vision/ and firmware/ entirely — 11,963 lines,
    about 80% of the codebase. A reader was shown the PCB scripts and told
    that was the project.
    - the pipeline was described as 'YOLO / MediaPipe', two rewrites out of date.
    It has been ONNX Runtime with SCRFD, ArcFace and a learned ReID embedding
    for some time.
    - nothing said the aircraft has never flown until well below the fold.
    Now: what it is in one sentence, then a STATUS block above the fold that
    volunteers the limits before listing any a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
2026-08-10 vision: evaluate the face-verification stage, and find the gallery was mislabelled
    match_thres = 0.36 and veto_thres = 0.15 were picked from a handful of observed
    similarity values. That is a fine way to choose a starting point and a bad way
    to justify shipping one, because it says nothing about how often the system
    locks onto the WRONG person.
    tools/verify_eval.py builds every same-person and different-person pair,
    sweeps the threshold, and reports both error rates with a Wilson interval —
    normal approximations are useless at zero errors, and zero is the case this
    hopes to report.
    The asymmetry is the design question and is now stated as one. A false reject
    costs one frame: the face sta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
2026-08-10 firmware: degrade to bring-up mode when the IMU is absent, instead of bailing
    A failed IMU used to return straight out of setup(). That kept the aircraft
    safe and made it undiagnosable: the early return sat ABOVE camera_begin() and
    blackbox_begin(), so a board without an IMU never started the camera, the
    PSRAM logger or anything that would let you find out why.
    That is exactly the state hardware arrives in. The ICM-42688-P and the VL53L1X
    live on the PURSUIT-1 PCB; a bare XIAO ESP32S3 Sense on a desk has neither, and
    is precisely the machine you want to verify the camera, the SoftAP, the UDP
    link, PSRAM and the battery divider on before any board exists.
    Now a missing or uncalibratable IMU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
    [main.cpp]
2026-08-10 vision: constant-velocity Kalman filter on the target state
    Lead compensation used the tracker's velocity, differenced per frame and
    scaled by dt. That works and has three problems that only appear on an
    aircraft: it is dominated by box jitter, which is then multiplied by a lead
    time and added straight to an attitude setpoint; it vanishes the moment a
    detection is missed, leaving the controller aiming at a stale point with no
    notion of how stale; and it cannot distinguish 'not moving' from 'not
    measured', which come back identically as zero and want opposite responses.
    pursuit/target_kf.py fixes all three from one model. Six states — box centre,
    box height, and their rates — with a piec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
2026-08-10 build: Dockerfile, Makefile, and a CI gate for the container
    The project was developed on Python 3.14 with CoreML on Apple silicon, which
    is a configuration nobody reviewing it will have. The container removes that
    as an obstacle: 3.12 on the CPU execution provider, no GPU, no NPU, no model
    weights — which is also a real test, because that is exactly the degradation
    path pursuit/onnxbase.py was written for and this is the first thing that
    exercises it.
    Weights are deliberately not baked in. They are ~309 MB, the InsightFace ones
    are licensed for non-commercial research use only and are not mine to
    redistribute, and everything that does not need them — protocol, link, lock
    machine, arbit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
2026-08-10 docs: architecture poster and section exports
    A 2200x2639 system architecture poster, designed in Figma rather than
    auto-laid-out from mermaid, exported at 2x. Four sections: the ML pipeline on
    the laptop, the wire protocol and what happens as it degrades, the on-board
    firmware cascade, and how to actually connect and fly it.
    Colour is semantic and the legend says so: blue is data and link, purple is
    machine learning, teal is control, amber is degraded-but-flying, red is a
    defect that would have crashed it, green is a verified fix. Inter for prose,
    Geist Mono for anything that is a measured value — so every number on the
    poster is findable by scanning for one typeface.
    Every figure is re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
2026-08-10 docs: mind-map view of the system
    A radial node graph — centre, four branches, curved bezier links — as an
    alternative to the poster's card grid. Same palette and the same semantic
    colour contract, but the edges carry the meaning: you can see at a glance that
    the ML and the flight control are two different subsystems joined only by a
    30-byte packet.
    Drawn with real vector paths rather than generated from mermaid, so the layout
    is deliberate: ML top-left, firmware bottom-left, link top-right, operating
    bottom-right, with the leaves ordered as the data actually flows.
    Every leaf is a fact from the source. The two red ones are the defects that
    would have destroyed the aircraft — the neg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
2026-08-10 docs: lead the README with the system mind map, and correct stale test counts
    The mind map goes above the fold, under the title and before the status block —
    it is the fastest way for a reader to see that this is two subsystems joined by
    a 30-byte packet, which is the whole shape of the project. Links through to the
    full-size file, since at README width the leaf detail is not readable.
    Also links the detailed architecture poster and its four sections from the
    'how it fits together' section, for a reader who has decided to look properly.
    Corrected counts that went stale when the target Kalman filter landed and I did
    not update the prose: 191 -> 207 Python (193 vision + 14 sim), 159 -> 175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
2026-08-10 docs: bring every Figma export into the repo, with a manifest
    All eleven figures now live in docs/media/ rather than only in Figma. Adds the
    four FigJam boards, which had never been exported — their nodes sat loose on
    the page with no wrapping frame, so there was nothing single to export until
    they were grouped.
    docs/media/README.md is the manifest, and it draws the distinction that
    actually matters: two figures are GENERATED and reproducible from source
    (lag_stability.png from sim/flight/lag_sweep.py, verification_roc.png from
    vision/tools/verify_eval.py), and nine are AUTHORED in Figma, where the PNG is
    an export and the Figma file is the master.
    That second category duplicates facts o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
2026-08-10 docs: LinkedIn carousel, generated from measured results
    vision/tools/make_deck.py builds a 10-slide 1080x1350 carousel and a combined
    PDF. Generated rather than designed by hand, for the same reason the wire
    protocol header is generated: every number on these slides already exists in
    this repository, and typing them into a design tool creates a second copy that
    nothing checks.
    The verification panel does not even use recorded numbers — it imports
    tools/verify_eval.py and recomputes the distributions, including the
    identity-collision merge. A slide that reimplements a metric can disagree with
    the tool that published it; importing makes that impossible.
    docs/media/measurements.json record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
2026-08-10 ml: train a face embedding on real data, and measure what pretrained buys
    There was no training anywhere in this project, so there was no honest way to
    show training work. This adds one, on real data, with the result reported as it
    came out.
    DATA. Labeled Faces in the Wild via sklearn — real photographs from news wire
    images, not synthetic and not augmented from a handful of faces. Restricted to
    identities with >=10 images: 4,324 photographs of 158 people.
    PROTOCOL, which is the part that actually matters. The split is by IDENTITY,
    not by image: 127 people to train on, 31 held out and never seen. Splitting by
    image instead — the flat train_test_split every tutorial reaches for — leav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
2026-08-10 ml: redraw the figures as plain scientific plots
    The first version was drawn on near-black with saturated blue/purple/green
    accents, rounded cards and accent bars. It looked generated — because that
    palette IS the Tailwind default those tools emit, and a reader pattern-matches
    it before reading a single number.
    For a figure whose whole job is to be believed, that is a self-inflicted wound.
    It is worse than an aesthetic problem: 'looks AI-generated' reads as PROMPTED
    rather than BUILT, which is the opposite of what a real training run and a
    92-point protocol comparison deserve.
    Now: white ground, black text, matplotlib's own blue and orange, thin lines,
    no cards, no rounded corners, legen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
2026-08-10 docs: rewrite the carousel copy flat, and give it room
    Two changes, both because the deck read as machine-made.
    COPY. The old slides were written in LinkedIn-aphorism voice: short declarative
    fragments, heavy em-dashes, every line landing a Point. 'I measured it instead
    of trusting it.' That cadence is now strongly associated with generated text,
    and it undercut the one thing the deck needs, which is to be believed. Rewritten
    flat and specific: what was done, on what data, and what the number was.
    PALETTE. Light, matching the training figures. The near-black-with-neon version
    was the Tailwind default that AI tools emit, and a reader pattern-matches it
    before reading a number.
    SPACING. Wid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
2026-08-10 ml: hold the epoch-35 label clear of the dotted rule
    At 0.84 axes-fraction the label's right edge was touching the rule. Moved to
    0.76, which measures as a 67 px gap in the rendered figure.
    The gap has to be explicit rather than eyeballed, because the rule's x position
    comes from the data — it moves whenever the run does — while the label is
    placed in axes coordinates and does not.
2026-08-10 ml: twelve plots, four to a figure, grouped by the question they answer
    Was ten across an uneven 4/4/2. Now three even figures, and the split is by
    QUESTION rather than by convenience:
    ml_training.png did the optimiser work?
    loss · identity accuracy · LR schedule · generalisation gap
    ml_evaluation.png how good is the verifier?
    score separation · ROC · DET · threshold sweep
    ml_decisions.png what should I do next?
    data scaling · embedding width · size vs accuracy · calibration
    Only the third changes an action, which is why it is the one worth showing
    first to anyone deciding whether this was real work.
    Two new plo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
2026-08-10 docs: LinkedIn carousel built in Figma, at LinkedIn's real constraints
    Six slides at 1080x1350 — 4:5, the tallest ratio LinkedIn accepts. Anything
    taller is centre-cropped rather than letterboxed, so a 9:16 design silently
    loses its top and bottom.
    Body type is 44 px minimum. On a 1080-wide canvas rendered at ~390 CSS px on a
    phone that is ~16 px, which is the floor for readable body text; the 32 px most
    carousel templates use lands at 11 px and cannot be read in-feed.
    Light ground, near-black text, muted accents, one idea per slide. Deliberately
    plain — the dark-with-neon version of this deck read as generated, and a post
    whose whole job is to be believed cannot afford that.
    Every nu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
2026-08-10 docs: portrait process diagrams for LinkedIn
    The existing mind map is 3340 px wide landscape. At LinkedIn's ~552 px feed
    width that is a 0.17x scale and none of it can be read — a wide radial diagram
    is the wrong shape for a phone regardless of how good it is.
    So these are the same content rebuilt vertically at 1080x1350: connected nodes
    with curved links, top to bottom, 36 px node titles and 27 px detail. Three
    flows, one per slide.
    1 the loop end to end, camera to motors, with the closing edge that makes
    it a loop rather than a pipeline
    2 identity — why one signal is not enough, ending on the veto
    3 the firmware cascade, ending on what happens when the link goes quiet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
2026-08-10 vision: correct the DualSense profile from measured hardware
    The PS5 profile had the two STICKS SWAPPED — roll and pitch on the left stick.
    RC mode 2, which is what anyone who has flown a quad expects, is throttle and
    yaw on the LEFT and pitch and roll on the RIGHT. Flying it the other way round
    is how a first flight ends while your hands are doing the right thing.
    Now set from bytes read off a real DualSense and verified by moving each
    control individually:
    yaw byte 1 throttle byte 2 (left stick)
    roll byte 3 pitch byte 4 (right stick)
    deadman byte 6 = R2, confirmed reaching 255
    Sticks report UP as ZERO, so invert_pitch and invert_throttle stand.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
2026-08-10 firmware: fuse the rangefinder and a barometer into one height
    Prep for the BMP390, which plugs into J2 and lifts the altitude-hold ceiling
    from 3.5 m to whatever you like. The driver is hardware; this is the part that
    has to be right, so it is written without Arduino headers and tested on the
    host.
    Two sensors with opposite failure modes. The VL53L1X is precise to a
    centimetre and reports TRUE height above the ground, and stops existing past
    3.5 m. The BMP390 works at any altitude but reports PRESSURE altitude against
    an arbitrary datum, drifts with the weather, and is noisy.
    THE TRAP, and the reason this is its own module: the barometer's zero is not
    the ground. Switch source at 3.5 m an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
    [altitude_fuse.cpp, altitude_fuse.h]
2026-08-10 firmware: BMP390 barometer driver
    The part that lets the altitude ceiling move off the rangefinder's 3.5 m.
    Fits on the existing I2C bus via J2 — 0x77 (0x76 with SDO low), no collision
    with the IMU at 0x68 or the ToF at 0x29, and nothing on the board changes.
    The chip reports raw ADC counts, not altitude. Turning those into pressure
    needs the factory trim from NVM and the datasheet's compensation polynomial
    (rev 1.4 s8.5), and the failure mode there is quiet: every trim coefficient
    carries its OWN power-of-two scaling, so borrowing a neighbour's exponent
    yields a pressure that looks entirely reasonable and is wrong by a constant
    factor. A constant factor in pressure is a constant factor i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
    [bmp390.cpp, bmp390.h]
2026-08-11 firmware: fly on the fused height, and cap the climb at what can be measured
    Wires the barometer and the fusion filter into the flight loop. Until now
    both existed and neither was reachable: altitude hold still read the
    rangefinder directly, so the ceiling was still 3.5 m.
    The rangefinder poll becomes the tick for the whole altitude path. It runs
    at 30 Hz whether or not the sensor answered, and pushes VALID-OR-NOT into
    the filter, because that same call is what ages both sources. Pushing only
    good samples would freeze the staleness check — a reading that never grows
    old is a reading the aircraft never stops trusting.
    The barometric datum is captured on the RISING EDGE of arming, not
    cont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
2026-08-11 docs: record the barometer in the project notes and README layout
    The altitude ceiling was a stated limitation in three places and is no
    longer one. Also names the two new source files and the I2C address to
    expect during bring-up.
2026-08-11 vision: rebuild the preview as an instrument rather than an overlay
    The old HUD printed values around the edges of the video. Everything was
    legible and nothing was organised — the eye had no idea where to look first,
    and each value's meaning was carried entirely by its own text. That is the
    difference between a debug overlay and an instrument, and it is why the
    window read as an OpenCV demo.
    The video is now composited into a designed surface: a header that answers
    "what is it doing", a deck that answers "what is it commanding and what is
    coming back", and the picture between them kept as clean as possible.
    Four changes carry most of it, and each is doing work:
    spotlight Everythin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
2026-08-11 vision: full-screen preview, 1080p capture, and a self-inflicted band
    --fullscreen (with [f] to toggle), --res WxH, [s] to toggle the spotlight.
    The window was AUTOSIZE, which locks it to the image's pixel size — it could
    be neither resized nor maximised. WINDOW_NORMAL fixes that, and the camera
    reports what it actually gave rather than what was asked for, because a
    camera hands you the nearest mode it has instead of refusing: a request for
    1080p that quietly landed on 720p is now visible at startup instead of being
    discovered later as "why does this look soft".
    The band down the side, and how I got it wrong twice
    ---------------------------------------------------
    A full-screen window w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
2026-08-11 docs: bring-up procedure, and the sign-off that gates calling this working
    VERIFICATION.md records what was checked before the gerbers went out. There
    was nothing for the other side of that — what gets checked when the boards
    come back, on the physical article. The README carried five lines of prose,
    which is not something you tick while holding a board and a multimeter.
    Ordered so that no step can destroy the one after it: shorts and JST polarity
    before power, the XIAO alone before the PCB can be blamed for it, rails and
    WHO_AM_I before sensors, orientation signs before anything spins, motor
    identity and rotation before props, power under load before flight, and the
    altitude handover las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
2026-08-15 firmware: enable PSRAM, and size the blackbox to what is actually there
    First boot on real hardware, and it found two faults that between them would
    have cost the entire tuning phase.
    1. PSRAM was never enabled
    ----------------------------
    esptool reports "Embedded PSRAM 8MB" on this chip, and the Arduino core does
    not bring it up on its own. platformio.ini carried no PSRAM configuration at
    all, so psramFound() returned false and the firmware printed:
    blackbox ABSENT (no PSRAM) — tuning will be blind
    Fixed with board_build.arduino.memory_type = qio_opi (the flash is quad, the
    PSRAM is octal) and -DBOARD_HAS_PSRAM.
    2. The request did not fit, and fixing (1) alone would not have help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
    [blackbox.cpp]
2026-08-15 firmware+vision: three fixes found by running against real hardware
    All three came out of the first bench session with a live XIAO. None of them
    were visible from the test suite, and two of them are the kind that only
    appear once electricity is involved.
    1. A fault must not promote the aircraft out of BOOT
    ----------------------------------------------------
    A bare XIAO has no battery divider, so VBAT reads 0.00V, the limiter latches
    critical, and main.cpp called emergency_land() at 50Hz. That fell through to
    enter(IDLE): the aircraft reported IDLE over telemetry while its own boot
    banner insisted it was held in BOOT.
    Arming was still correctly refused — that gate is sensors_ok_, which i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
    [config.h, flight_state.cpp, main.cpp, test_flight.cpp]
2026-08-15 docs: bring-up must decode a camera frame, not trust the boot line
    `camera ok` only means camera_begin() returned. Verified today by pulling
    400KB off the stream: 40 JPEG markers, one complete frame decoding at
    800x600.
    The resolution is the check that matters. camera.cpp falls back to QQVGA
    (160x120) when PSRAM is absent, and PSRAM was absent until this morning — so
    the module was streaming 160x120, where by the file's own arithmetic a face
    is about 6px at 3m instead of 31px. The aircraft could lock a target and then
    be unable to find them again. Fixing PSRAM restored the blackbox AND the
    camera resolution; only one of those announced itself at boot.
2026-08-15 tools: run the vision stack against the aircraft's own camera
    The real data path is OV2640 -> JPEG -> WiFi -> ONNX on the laptop. A webcam
    test exercises none of it: not the compression artefacts, not the link
    latency, not the lens the aircraft actually flies with.
    Doing it by hand means joining a SoftAP with no internet, remembering the
    right interpreter, and remembering to switch back. The restore is on a trap
    covering EXIT, INT and TERM, so the network returns whether you quit with x,
    Ctrl-C, or it crashes.
2026-08-15 firmware: configure white balance, and let the bench see what it is doing
    Both came out of running the vision stack on the module's own camera for the
    first time. The picture was a near-black silhouette with a yellow-green cast,
    and only one of those two things was intentional.
    White balance was never configured
    -----------------------------------
    camera.cpp set vflip, gain ceiling, ae_level and aec2, and never touched AWB.
    Under tungsten every frame came back heavily cast.
    That is not cosmetic. A face embedding is not colour-invariant, so a cast
    present at enrolment and absent at match time — or the reverse — costs
    similarity on every single comparison, and the entire identity layer i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
    [benchtest.cpp, camera.cpp, camera.h, config.h]
2026-08-15 docs: process mind-map — the runtime path, and its generator
    The existing pursuit_mindmap.png is the static SYSTEM view: what connects to
    what. This is the complementary RUNTIME view — a single camera frame becoming
    four motor commands, as a left-to-right serpentine so the eye follows the
    flow: perception on the laptop (top, L->R), the radio handoff (right), the
    1 kHz flight loop on the aircraft (bottom, R->L), ending at the motors.
    Unlike the original mind-map, the generator is committed, so the numbers are
    refreshed in one place rather than redrawn by hand.
2026-08-16 docs: polish the process map — depth, numbered stages, flowing connectors
    Same runtime-path content, substantially more presentable. Node bloom haloes
    and a glassy top edge give depth; 01-10 badges and monospace role tags make
    the sequence legible at a glance; flow dots ride each connector so the wires
    read as data moving; a radial vignette and faint dot grid replace the flat
    black. All layered patches — still no rasteriser dependency, still one place
    to change the numbers.
2026-08-16 docs: process map goes light, and gains the steps it was hiding
    Switched to the light editorial style that matches the carousel — flat white
    cards, crisp borders, one accent per lane, no glow or dot-grid. Restraint
    over decoration.
    Expanded 10 stages to 14 by surfacing the ones that were collapsed or buried:
    LOCK the 4-state machine that coasts through an occlusion
    ARBITRATE manual/assist/follow + the deadman — who is actually flying
    FUSE rangefinder + barometer blended into one height
    PROTECT battery sag limiter + the watchdog, no longer just a footer
    Fixed a layout collision where the title's accent underline struck through
    the lane caption; removed the un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
2026-08-16 docs: fill the dead middle with a hero card
    The empty band between the two lanes wasted space and made the whole image
    read small once LinkedIn scaled it down. Now a central identity card sits in
    it — PURSUIT-1, one line, and four measured headline stats (66 g, 337 tests,
    1 kHz, 25 fps) — with the 14-stage flow wrapping around it as a U.
    Numbers are counted, not claimed: 111 native (pio test -e native) + 212
    vision + 14 sim = 337.
2026-08-16 docs: cut the process map to six steps, in plain English, with emoji
    Fourteen stages was the engineer's version of this story. Someone scrolling
    LinkedIn does not need LOCK, ARBITRATE and FUSE as separate boxes — they need
    to understand the machine in ten seconds. Six steps, and the jargon replaced
    with what it actually means: 'correct its own tilt a thousand times a second'
    instead of 'angle P to rate PID, D on measurement'.
    Emoji go through PIL from Apple Color Emoji and composite as images.
    Matplotlib cannot draw colour emoji itself — its default font has no glyphs
    for most of them and silently draws empty boxes — so setting them as text
    would have shipped tofu that nobody noticed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
2026-08-17 Extend link range: quiet channel, explicit TX power, RANGE video mode
    Three changes aimed at the WiFi link, which is what actually bounds how far
    the aircraft can go — not the battery and not the motors.
    CHANNEL. softAP() with no channel argument lands on 1, the most congested of
    the three non-overlapping 2.4GHz channels in any built-up area. Outdoors the
    limit on this link is almost never transmit power, it is other people's
    networks. Moved to 6 and capped the AP at one client, so a neighbour's phone
    probing the SSID cannot take airtime from the laptop.
    TX POWER. Set explicitly to 19.5 dBm. The Arduino default is already at or
    near maximum so this buys little in itself; it removes a sil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
2026-08-18 Fix two flight-critical constants found during first hardware bring-up
    The fabricated board arrived and was hand-assembled (JLCPCB did SMD; headers,
    motors and battery lead soldered here). Bringing it up on real silicon found
    two defects that every host test had passed straight over.
    IMU ORIENTATION. The bench 'o' test showed the fitted ICM-42688-P sits rotated
    180 degrees in yaw relative to the USB-C-forward body frame. With the shipped
    identity mapping, flat read +1g on Z (up was correct) but:
    right-edge-down -> NEGATIVE roll (spec says positive)
    nose-down -> NEGATIVE pitch (spec says positive)
    Both axes inverted. Every attitude correction would have been applied
    ba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
    [alt_hold.cpp, config.h]
2026-08-19 Fix three flight-safety defects found by inspection during bring-up
    All three were found by reading the code on 2026-08-19, while diagnosing
    why the aircraft reported 1.47V on the pack during its first armed run.
    None had ever been exercised in flight, because it has never flown.
    1. emergency_land() was not idempotent. LANDING was missing from the
    sticky-state list, so the second call fell through to enter(IDLE),
    which clears motors_enabled(). main.cpp calls it on every battery
    tick while critical() is true, and critical() latches — so a flat
    pack bought exactly one 20ms tick of controlled descent and then cut
    the motors. The function turned into the fall it exists to preve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
    [flight_state.cpp, flight_state.h, main.cpp, test_flight.cpp]
2026-08-19 Bench: run all four motors together, and count I2C failures
    Both of these exist to make tomorrow's session measurement-only. Neither
    has been run on hardware.
    Four-motor bench mode ('A'). Until now there was no way to run four
    motors at once: 'a' called run_motor(0) and spun M1 alone while the help
    text claimed it swept all four. So the largest current this airframe can
    draw had never once been demanded of the pack, and every four-motor
    figure in the docs was a single-motor measurement multiplied by four.
    Ramped over 1.5s rather than stepped. Four coreless motors going
    stopped -> duty inside one PWM period is the worst transient the board
    can produce, and the 3V3 rail has only ~8uF behind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
    [benchtest.cpp, icm42688.cpp, icm42688.h]
2026-08-19 Reject impossible VBAT samples: the sag was the ADC, not the pack
    Two days were spent diagnosing a power path that turned out to be fine.
    This records what actually happened, because the failure looked exactly
    like the real thing.
    The symptom: on the first armed run the aircraft reported 1.47V and
    tripped emergency_land(). A bench sweep then showed pack voltage falling
    perfectly linearly with motor duty -- 0.0095 V per 1% per motor, r^2
    essentially 1 -- which extrapolated to a pack that could not hold four
    motors at 14% duty, let alone hover. Every sign of a high-impedance pack
    or a bad joint.
    It was the sense chain. Measured 2026-08-20: with PWM running the ADC
    returned 1.70V at 0% duty a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
    [battery.cpp, battery.h, benchtest.cpp, config.h, main.cpp, test_battery.cpp]
2026-08-19 Refuse to arm on a latched-flat pack
    Closes the last gap left by the LANDING timeout. Without this, a
    critical battery gives a ~2s oscillation: an arm packet takes IDLE ->
    ARMED, the next battery tick drives ARMED -> LANDING, the new LANDING
    timeout disarms back to IDLE, and a still-held arm button starts it
    again. Motors spin for a couple of seconds per cycle, on the one pack
    that can least afford it.
    Held back deliberately until now. Yesterday the VBAT sense chain was
    still suspect, and an interlock keyed on critical() would have grounded
    a healthy aircraft on a phantom reading with a confusing symptom. The
    ADC glitch fix removed that risk: critical() is driven by the SLOW (2s)
    filtered v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
    [flight_state.cpp, flight_state.h, main.cpp, test_flight.cpp]
2026-08-19 Bench: dump the flight log as CSV over USB
    The blackbox already serves over WiFi at 192.168.4.1:82, but reading it
    that way means leaving your own network and joining the aircraft's AP
    after every single hop. That friction is why flight logs go unread, and
    tuning without logs is guesswork -- which is the whole reason the
    blackbox exists.
    On the bench the USB cable is already attached. 'd' now prints the log
    as CSV over it, oldest record first, with the bb_scale_* transforms
    inverted so the numbers are in real units rather than raw counts.
    Text rather than the packed 40-byte record: the point is to paste it
    into something that plots, not to save four bytes.
    blackbox_peek() was previously c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
    [benchtest.cpp, blackbox.cpp, blackbox.h]
2026-08-19 Profile the loop, and stop paying 810us for a battery reading
    3.5% of loop iterations were exceeding the 1ms budget (worst 1.31ms)
    with no attribution at all. Adds a section profiler on 'p' and uses it.
    The first hypothesis was wrong, which is why the profiler exists. The
    obvious suspects were the absent ToF and barometer being polled against
    a dead I2C bus -- config.h documents such a read blocking for ~7.5ms --
    but Bmp390::read() and Rangefinder::update() both early-return on
    !present_/!ready_, so they cost 2-3us and nothing else.
    Measured instead (20s idle, 32k laps, mean_us / WORST_us):
    serial+link 44.6 / 1043
    attitude 515.1 / 893
    battery 25.3 / 1022
    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
    [benchtest.cpp, main.cpp]
2026-08-19 Fix the biometric hygiene gate, which had never passed
    Two bugs, found by tripping over both at once while landing the face-ID
    work.
    The gitignore rule is `vision/targets/*.npz`. A bare star does not match
    subdirectories, so moving an enrolment session into
    vision/targets/sessions/ silently escaped it -- and a `git add
    vision/targets/` then staged a face embedding. Face embeddings are
    biometric data under UK GDPR and the gitignore's own comment says
    nothing derived from a real person's face belongs in a public repository,
    ever. Removed from the index and amended out before it was pushed, and
    both gitignores now carry an explicit `targets/**/*.npz`.
    The CI gate that exists to catch exactly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
2026-08-19 Never mirror the drone's own camera feed
    Found while setting up to run the pipeline against the aircraft's MJPEG
    stream instead of a laptop webcam. It would have inverted every lateral
    correction.
    open_source() returned `live`, and the flip was gated on it:
    if live and cfg.source.flip:
    frame = cv2.flip(frame, 1)
    `live` is True for a network stream as well as a webcam, and
    `source.flip` defaults to True. So pointing --source at
    http://192.168.4.1:81/ would have mirrored the aircraft's own view.
    Mirroring is right for a webcam: it faces the operator, so the flip makes
    left/right read naturally while testing. The drone's camera faces AWAY
    from the operator and its frames are alr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
2026-08-19 Bench: drive each motor gate pin as plain GPIO ('g')
    All four motors went silent at once. A meter read 0V across M1 while it
    was commanded at 35%, with VBAT healthy at 3.6V on J1 -- so power was
    present and the FETs were not switching. That narrows it to gate drive
    but not to a cause: a dead MCU pin, a broken header joint and a
    misconfigured LEDC peripheral are indistinguishable from the motor's end.
    'g' drives each gate pin HIGH through plain digitalWrite for 4s, one at a
    time, bypassing LEDC entirely. A steady 3.3V is also far easier to read
    on a multimeter than the ~1.15V average of a 35% duty cycle, which is
    easy to mistake for noise.
    Root cause turned out to be cold joints on the XIAO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
    [benchtest.cpp]
2026-08-19 Measure hover throttle: 0.79 was never right, it is ~0.30
    Found because the operator noticed the airframe straining against its
    restraint during a props-on ramp and said so. Props on, board held down,
    four motors stepped up: nearly free of the surface at 29% per motor. So
    hover is near 0.30, not 0.79.
    The 0.79 was never measured. It came from a thrust-to-weight estimate of
    ~1.6 -- hover near sqrt(1/1.6) -- and that 1.6 came from the SPICE power
    model whose assumptions have now been contradicted twice on hardware.
    The real airframe is much better than modelled: hovering at ~30%
    throttle implies a T:W nearer 3.
    Why it matters, and why upward is the dangerous direction: hover_ is the
    FEEDFORW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
2026-09-28 Firmware: derived hover baseline, voltage-compensated hover, task watchdog
    - hover_ = 0.69, derived from the airframe's own mass and thrust figures.
    The previous 0.30 came from a bench sweep capped at 35% duty, so it only
    bounded hover from below. Still unmeasured: the bench tool gains a
    thrust-sweep mode (T, up to 85% duty, props on, restrained) to measure it
    on a scale.
    - Hover baseline is scaled by pack voltage, so a failsafe descent on a
    sagged pack still has enough throttle (audit C3).
    - Hardware task watchdog armed at the end of setup (audit C4).
    - Gyro calibration failures report the peak rate per axis.
    - Comments updated for the rev B 10k/10k battery divider.
    Work from 202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
    [alt_hold.cpp, alt_hold.h, benchtest.cpp, config.h, icm42688.cpp, main.cpp]
2026-09-28 Vision: re-verify identity by face on a schedule
    The face embedder reads to ~2.4 m but the follow standoff is 3.0 m, so a
    lock held at standoff was sustained by body re-identification alone and
    never re-checked. After 12 s of body-only confirmation the controller now
    closes to 2.0 m until a face confirms identity, and backs off after 8 s if
    none does. Disabled gives the old behaviour. 5 tests.
    Written 2026-08-30, committed 2026-09-28.
2026-09-28 Hardware rev C: 4-layer board, relieved hand-solder pads, 10k divider
    - 4 layers: signal / solid GND / solid VBAT / signal.
    - Every hand-soldered through-hole pad gets thermal relief except the three
    battery connectors. All rev A faults were cold hand joints on pads tied
    solid into the pour.
    - Battery divider 100k/100k -> 10k/10k (5 kOhm source for the ESP32-S3
    sample-and-hold), and three test points.
    - JLCPCB CPL: AO3400A (C20917) rotated 180 degrees to match JLCPCB's own
    footprint, checked by preflight.py.
    - Netlist otherwise identical to the rev A board that ran on the bench.
    preflight.py: 0 failures, 0 warnings.
    Work from 2026-08-21 to 2026-09-21, committed together on 2026-09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
    [BOM.csv, JLCPCB_BOM.csv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]
2026-09-28 Stop tracking local tool configuration and social-media slides
    Removes from the tree (the files stay on disk and in history): the
    coding-assistant config, the SKiDL pipeline state file, and the LinkedIn
    carousel with its generator, whose slides predate fabrication and say the
    boards are not fabricated.
2026-09-28 README: current status, measured bench results, build guide split out
    The README said the boards were not yet fabricated and quoted old test
    counts. It now states what was measured on the rev A board on the bench,
    what has not been done (it has not flown), and keeps the stability and
    face-model results. Ordering, assembly, first power-up, design compromises
    and the mass budget move unchanged to docs/BUILD.md, with the CPL rotation
    note corrected for the Q1 to Q4 fix.
2026-09-28 CI: install scipy, and the vision dependencies for the protocol check
    First run on GitHub failed three jobs. vision/pursuit/bytetrack.py needs
    scipy (linear_sum_assignment), which neither the vision job nor the Docker
    image installed, and the protocol-drift job installed nothing although
    gen_protocol_header.py imports the pursuit package. Checked in a clean
    Python 3.12 environment built from requirements-docker.txt: 209 passed,
    18 skipped (model weights absent), sim 14 passed, header current.
