DerKodex-Repo-Curator/pursuit-drone/(notices)

Notices in the files:
README.md:
[](https://github.com/Pai-88/pursuit-drone/actions/workflows/ci.yml) · MIT licence
